eSpark-Consulting-Group/issamsmaali-energymonitor/Design Files/Power_Board-V1.0/Deliverables/Renderings/Power_Board_BOTTON3D.png

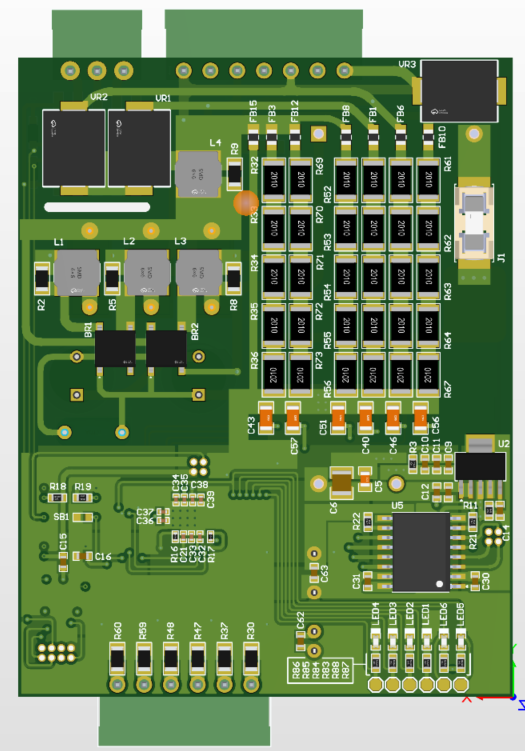
Design Files/Power_Board-V1.0/Deliverables/Renderings/Power_Board_BOTTON3D.png
