eSpark-Consulting-Group/issamsmaali-energymonitor/Design Files/Power_Board-V1.0/Deliverables/BOM/Client-BOM_Power_Board-V1.0.xlsx

# | Item Type | Designator | Description | Footprint | Manufacturer Part Number | Manufacturer | Comment | Quantity | #Column Name Error:' Remarks
1 | Bridge | BR1, BR2 | 30A 950mV@400mA 1A 800V LMBS-1 Bridge Rectifiers ROHS | LMBS-1 | LMB8S-TP | MCC(Micro Commercial Components) | LMB8S-TP | 2
2 | Film Capacitors | C1, C4, C8 | CAP FILM 0.1UF 20% 630VDC RADIAL | B32921C3104M000 | B32921C3104M000 | TDK EPCOS | 0.1uF | 3
3 | Capacitor | C2, C7 | 33uF 420V 1Ω@100kHz 430mA@100kHz ±20% Plugin,D10xL16mm Aluminum Electrolytic Capacitors - Leaded ROHS | 87EC0494 | 87EC0494 | KNSCHA | 33uF | 2
4 | Capacitor | C3 | 10nF -40℃~+100℃ ±5% 1kV Through Hole,P=7.5mm Film Capacitors RoHS | MPBH103J3A0701 | MPBH103J3A0701 | KYET | 10nF | 1
5 | Capacitor | C5 | Multilayer Ceramic Capacitor, 0.1 uF, 50 V, ± 10%, X7R, 0805 [2012 Metric] | Cap-0805 | CL21B104KBCNNNC | Samsung | 0.1uF | 1
6 | Capacitors | C6 | CAP CER 10UF 50V X7R 1210 | Cap-1210 | CC1210KKX7R9BB106 | Yageo | 10uF | 1
7 | Capacitors | C9, C13 | CAP CER 0.1UF 25V X7R 0603 | Cap-0603 | CC0603JRX7R8BB104 | Yageo | 100nF | 2
8 | Capacitor | C10, C11, C12 | CAP CER 4.7UF 16V X5R 0603 | Cap-0603 | CC0603KRX5R7BB475 | Yageo | 4.7uF | 3
9 |  | C14 | CAP CER 10000PF 50V C0G/NP0 0603 | Cap-0603 | GRM1885C1H103JA01D | Murata | 0.01uF | 1
10 | Capacitors | C15, C16, C30, C31 | CAP CER 0.1UF 50V X7R 0603 | Cap-0603 | GCJ188R71H104KA12D | Murata | 0.1uF | 4
11 | Capacitors | C21 | CAP CER 1UF 35V X5R 0402 | Cap-0402 | C1005X5R1V105K050BC | TDK | 1uF | 1
12 | Capacitor | C28, C29 | CAP CER 15PF 50V C0G/NPO 0603 | Cap-0603 | CC0603JRNPO9BN150 | Yageo | 15pF | 2
13 | Capacitor | C32, C34, C36, C38 | CAP CER 0.1UF 25V X5R 0402 | Cap-0402 | CC0402KRX5R8BB104 | Yageo | 100nF | 4
14 |  | C33, C35, C37, C39 | CAP CER 4.7UF 16V X5R 0402 | Cap-0402 | CL05A475MO5NUNC | Samsung | 4.7uF | 4
15 | Capacitors | C40, C43, C46, C51, C56, C57 | CAP CER 0.022UF 500V X7R 1206 | Cap-1206 | CC1206KKX7RBBB223 | Yageo | 22nF | 6
16 | Capacitor | C41, C42, C44, C45, C47, C48, C49, C50, C52, C53, C54, C55 | CAP CER 0.022UF 50V X7R 0603 | Cap-0603 | CC0603KRX7R9BB223 | Yageo | 22nF | 12
17 | Capacitor | C62 | CAP CER 10UF 10V X7R 0603 | Cap-0603 | GRM188Z71A106KA73D | Murata | 10uF | 1
18 | Capacitors | C63 | CAP CER 4.7UF 10V X7R 0603 | Cap-0603 | GRM188Z71A475KE15D | Murata | 4.7uF | 1
19 | Diodes | D1, D2, D3, D4, D5, D6 | DIODE ARR GP 100V 215MA TO-236AB | SOT-23 | BAV99,215 | Nexperia | BAV99,215 | 6
20 | Diode | D9, D10 | DIODE SCHOTTKY 40V 1A SOD123 | SOD-123 | 1N5819HW-7-F | Diodes | 1N5819HW-7-F | 2
21 | Ferrite Beads | FB1, FB2, FB3, FB4, FB5, FB6, FB7, FB8, FB9, FB10, FB11, FB12, FB15 | FERRITE BEAD 1.5 KOHM 0805 1LN | Ind-0805 | BLM21BD152SN1D | Murata | BLM21BD152SN1D | 13
22 | Fuse Holders | J1 | FUSE BLOK CARTRIDGE 125V 10A SMD | 01550900M | 01550900M | Littelfuse | 01550900M | 1
23 | Terminal Blocks | J2 | TERM BLOCK HDR 7POS 3.50MM | 691322110007 | 691322110007 | Wurth Elektronik | 691322110007 | 1
24 | Terminal Blocks | J3 | TERM BLOCK HDR 6POS 3.50MM | 691322110006 | 691322110006 | Wurth Elektronik | 691322110006 | 1
25 | Terminal Blocks | J4 | TERM BLOCK HDR 3POS 3.50MM | 691322110003 | 691322110003 | Wurth Elektronik | 691322110003 | 1
26 | Headers | J7, J8 | Socket Strip, Cuttable, Double Row, 0.050"x0.050" Pitch | SFMC-102-X1-XX-D - 570 |  | SAMTEC | SFMC-102-X1-XX-D | 2
27 | Header | J9 | Socket Strip, Cuttable, Double Row, 0.050"x0.050" Pitch | SFMC-104-X1-XX-D - 570 |  | SAMTEC | SFMC-104-X1-XX-D | 1
28 | Signal Relays | K1 | RELAY TELECOM DPDT 500MA 5V | TQ2SA-L2-5V-Z | TQ2SA-L2-5V-Z | Panasonic | TQ2SA-L2-5V-Z | 1
29 | Inductor | L1, L2, L3, L4 | 420mA 470uH Magnetic Shielded Inductor ±20% 500mA 1.8Ω SMD,6x6mm Fixed Inductors ROHS | XRNR6045-470uH/M | XRNR6045-470uH/M | XR | 470uH | 4
30 | LED | LED1, LED2, LED3, LED4, LED5, LED6 | Emerald 0603 Light Emitting Diodes (LED) ROHS | LED-0603 | NCD0603G2 | Foshan NationStar Optoelectronics | Emerald | 6
31 | MOSFETs | Q1, Q2 | MOSFET BVDSS: 8V~24V SOT23 T&R 3 | SOT-23 | DMG3420UQ-7 | Diodes | DMG3420UQ-7 | 2
32 | Resistor | R1, R4, R7 | 3W 1Ω SMD ±50ppm/℃ Current Sense Resistor ±1% 2512 Chip Resistor - Surface Mount RoHS | RES-2512 | HoLRT2512-3W-1R-1 | Milliohm | 1R | 3
33 | Resistors | R2, R5, R8, R9 | RES 10K OHM 1% 1/2W 1206 | Res-1206 | AC1206FR-7W10KL | Yageo | 10K | 4
34 | Resistor | R3 | RES 0 OHM JUMPER 1/10W 0603 | Res-0603 | RC0603JR-070RL | Yageo | 0R | 1
35 | Resistor | R11 | RES 0 OHM JUMPER 1/10W 0603 | Res-0603 | RC0603JR-070RL | Yageo | DNP | 1
36 | Resistors | R12, R15, R77, R79 | RES 0 OHM JUMPER 1/16W 0402 | Res-0402 | RC0402FR-070RL | Yageo | 0R | 4
37 | Resistors | R13, R14 | RES 0 OHM JUMPER 1/16W 0402 | Res-0402 | RC0402FR-070RL | Yageo | DNP | 2
38 | Resistor | R16 | RES 10K OHM 1% 1/16W 0402 | Res-0402 | RC0402FR-0710KL | Yageo | 10K | 1
39 | Resistor | R17 | RES 10K OHM 1% 1/16W 0402 | Res-0402 | RC0402FR-0710KL | Yageo | DNP | 1
40 | Resistor | R18, R19, R21, R22 | RES SMD 4.7K OHM 1% 1/10W 0603 | Res-0603 | RC0603FR-074K7L | Yageo | 4.7K | 4
41 | Resistor | R20, R89 | RES 1K OHM 1% 1/16W 0402 | Res-0402 | RC0402FR-071KL | Yageo | 1K | 2
42 | Resistor | R23, R24, R25, R26, R32, R33, R34, R35, R40, R41, R42, R43, R52, R53, R54, R55, R61, R62, R63, R64, R69, R70, R71, R72 | 0.75W Thick Film Resistors 200V ±100ppm/℃ ±5% 200kΩ 2010 Chip Resistor - Surface Mount ROHS | RES-2010 | FRC2010J204 TS | FOJAN | 200K | 24
43 | Resistor | R27, R36, R46, R56, R67, R73 | 1W 1kΩ 300V ±100ppm/℃ Thick Film Resistor ±5% 2010 Chip Resistor - Surface Mount RoHS | RES-2010 | HP101WJ0102T4E | UNI-ROYAL | 1K | 6
44 | Resistor | R28, R38, R44, R49, R57, R65 | RES SMD 0R, 1%, 0.1W, 0603 | Res-0603 | RC0603FR-070RL | Yageo | 0R | 6
45 | Resistor | R29, R39, R45, R50, R58, R66 | RES SMD 1K OHM 1% 1/10W 0603 | Res-0603 | RC0603FR-071KL | Yageo | 1K | 6
46 | Resistor | R30, R37, R47, R48, R59, R60 | RES 5.1 OHM 5% 1/4W 1206 | Res-1206 | RC1206JR-075R1L | Yageo | 5.1R | 6
47 | Resistor | R83, R84, R85, R86, R87, R88 | RES SMD 680 OHM 1% 1/10W 0603 | Res-0603 | RC0603FR-07680RL | Yageo | 680R | 6
48 | Resistor | R90, R91 | RES 100K OHM 1% 1/16W 0402 | Res-0402 | RC0402FR-07100KL | Yageo | 100K | 2
49 | Voltage Regulators - Switching | U1 | AC/DC CONVERTER 5V 5W | RAC05-05SK/480 | RAC05-05SK/480 | Recom Power | RAC05-05SK/480 | 1
50 | IC | U2 | IC REG LINEAR 3.3V 1A SOT223-6 | SOT-223-6_ | TPS79633DCQR | Texas Instruments | TPS79633DCQR | 1
51 | IC | U3 | IC AFE 7 CHAN 40LFCSP-WQ | 40-LFCSP-WQ (6x6) | ADE9000ACPZ | Analog Devices | ADE9000ACPZ | 1
52 | IC | U4, U5 | DGTL ISO 5000VRMS 4CH GP 16SOIC | SOIC-16-300mil | ISO7741DWR | Texas Instruments | ISO7741DWR | 2
53 | Module | U6 | SIP-4 Isolated Power Modules ROHS | B0503S-2WR3 | B0503S-2WR3 | YLPTEC | B0503S-2WR3 | 1
54 | Varistor | VR1, VR2, VR3 | 710V 350V 275V Through Hole,P=10mm Varistors ROHS | 4032 | 20D431K | SURGING | 20D431K | 3
55 | Crystal | X1 | 24.576MHz Surface Mount Crystal 12pF ±10ppm ±20ppm SMD3225-4P Crystals ROHS | SMD3225-4P | X322524576MOB4SI | YXC | 24.576MHz | 1
