eSpark-Consulting-Group/issamsmaali-energymonitor/Design Files/Power_Board-V1.0/Deliverables/Supporting Files/Power_Board-V1.0.step

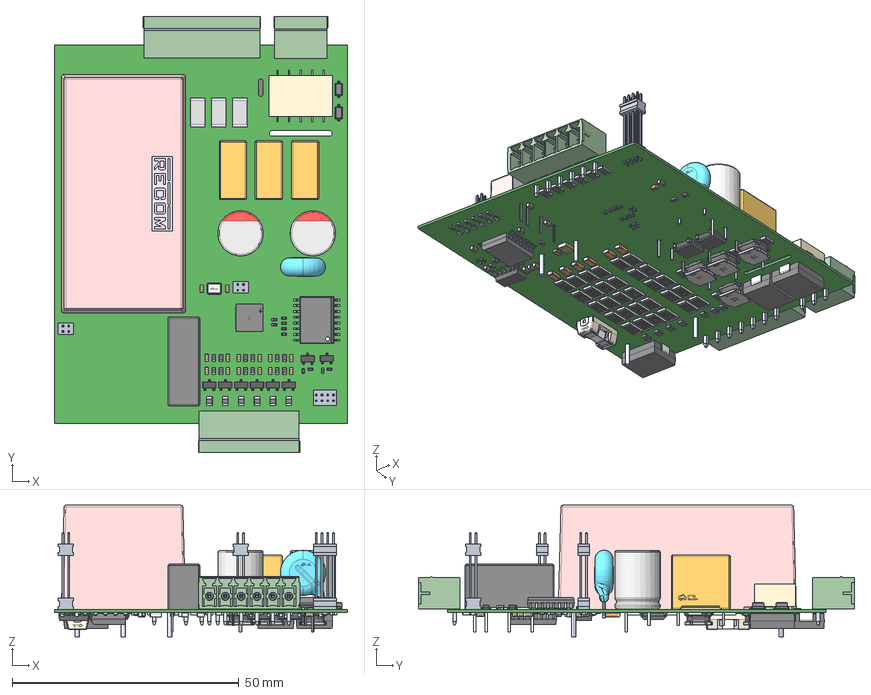
[picture p6: CAD file, 2026-02-13]
Design Files/Power_Board-V1.0/Deliverables/Supporting Files/Power_Board-V1.0.step
64.6 x 96.2 x 29.0 mm
_FW-04-01-G-D-570-100_bottom_body
_FW-04-01-G-D-570-100_pins1
_FW-04-01-G-D-570-065_pins2
_FW-04-01-G-D-570-100_top_body
_FW-02-01-G-D-570-100_bottom_body x 2
_FW-02-01-G-D-570-100_pins1 x 2
_FW-02-01-G-D-570-065_pins2 x 2
_FW-02-01-G-D-570-100_top_body x 2
User Library-CR3216-1206 x 10
User Library-R_2010 x 30
User Library-RESC1608X05N x 24
User Library-User Library-Siward_SX3225
ISO1050DWR x 2
User Library-SOT-223-6
RAC05-05SK_480
User Library-RES_1005-0402 x 12
CircuitWorks-RESISTOR 2512 x 3
CircuitWorks-SOT-23 x 8
User Library-LED SMD0603 x 6
RELAY-SMD_TQ2SA-3V~RELAY-SMD_TQ2SA-3V~12Oy
6913221100xx_PIN x 16
1N5819HW-7-F--3DModel-STEP-56544 x 2
User Library-CAPC1608X09 x 26
User Library-1206 SMD Capacitor x 6
User Library-Capacitor 0402 x 9
User Library-CAPC3225X10
User Library-0805 SMD Capacitor
