eSpark-Consulting-Group/issamsmaali-energymonitor/(list of files, cad)

Other CAD files:
docs/Client-Files/P24- board1.DWG
docs/Client-Files/25_0510000_bl(Alternate).dxf
Design Files/Power_Board-V1.0/Deliverables/Supporting Files/Power_Board-V1.0.DWG
Design Files/Power_Board-V1.0/Deliverables/Supporting Files/Power_Board-V1.0.DXF
