eSpark-Consulting-Group/issamsmaali-energymonitor/Design Files/Power_Board-V1.0/Power_Board-V1.0.pdf

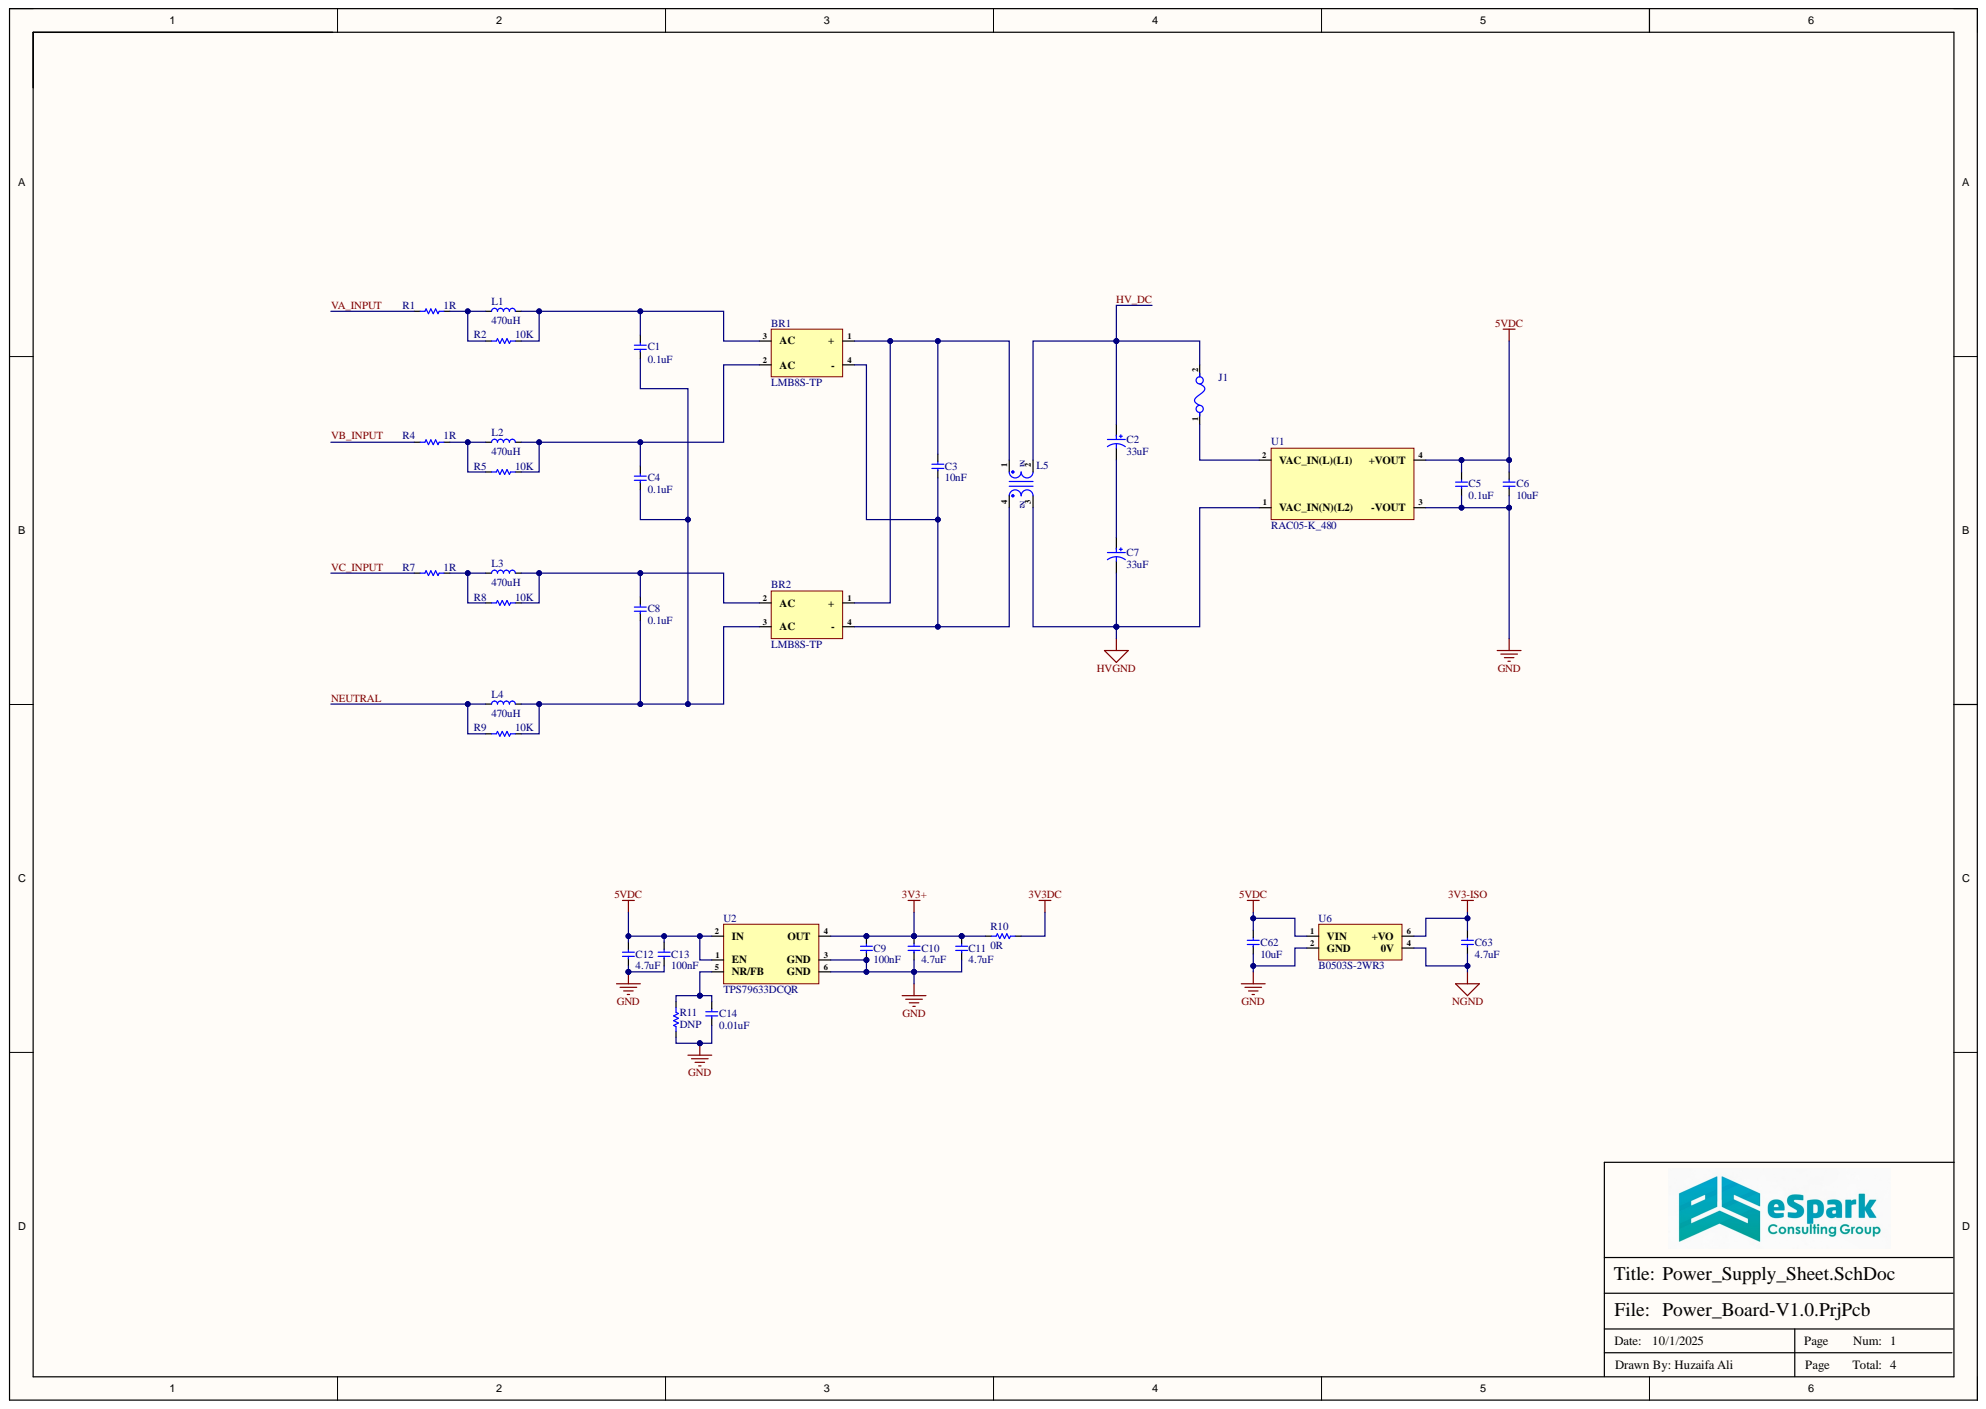
[picture p7: page 1]

Date: 10/1/2025 | Page Num: 1

Drawn By: Huzaifa Ali | Page Total: 4

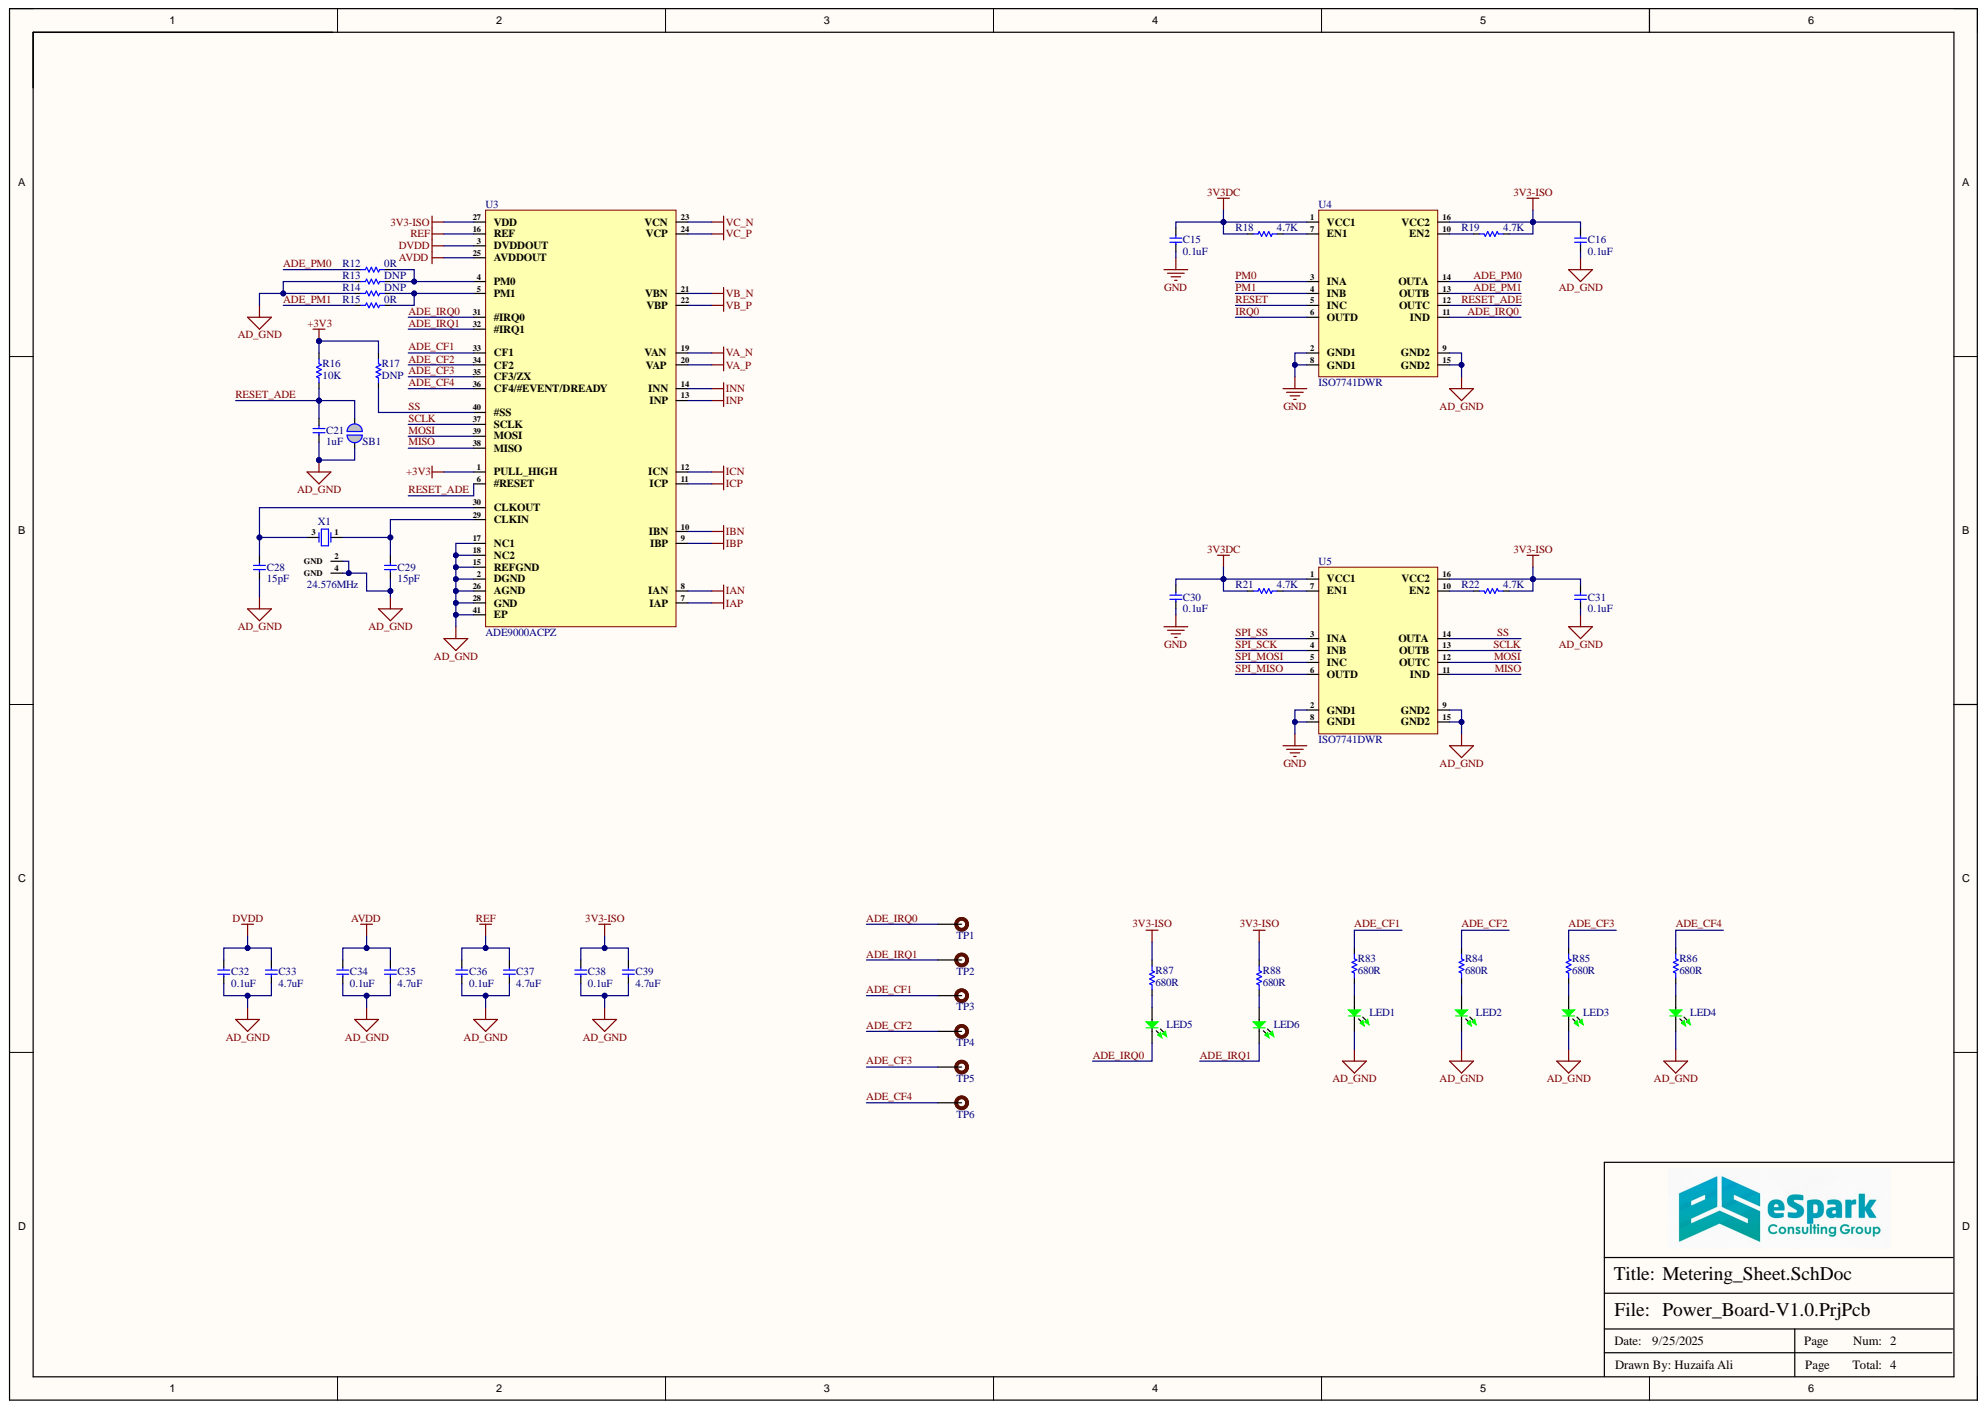
[picture p8: page 2]

Date : 9/2 5/2 0 2 5 | P a g e Nu m : 24

Drawn By: Hu z aifa Ali | P a g e T ota l :

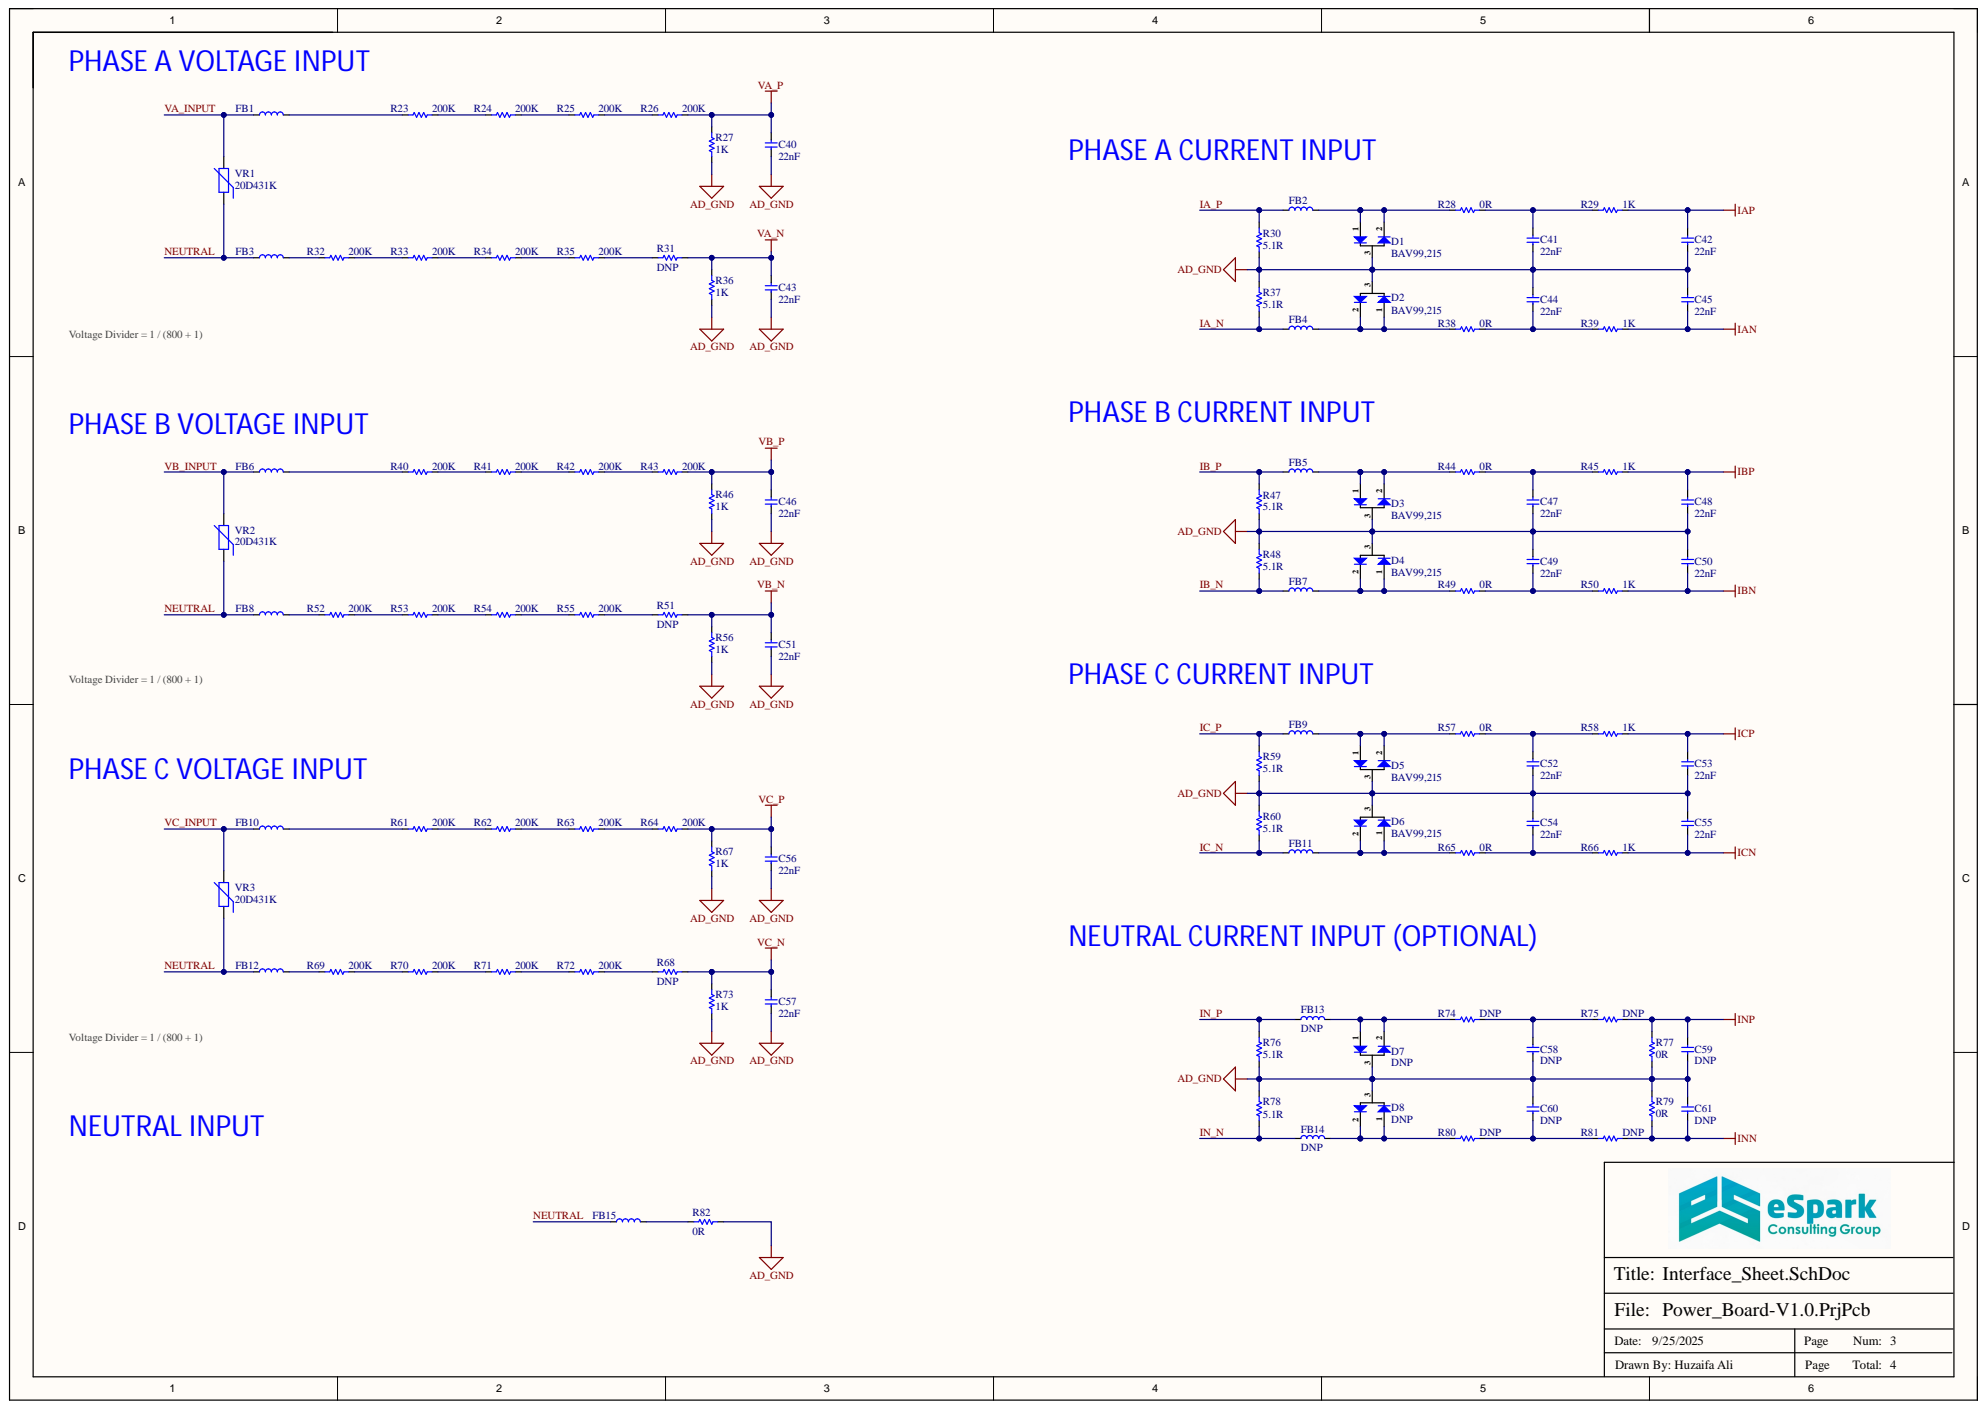
[picture p9: page 3]

Voltage Divider = 1 / (800 + 1) Voltage Divider = 1 / (800 + 1) Voltage Divider = 1 / (800 + 1)

NEUTRAL CURRENT INPUT (OPTIONAL)

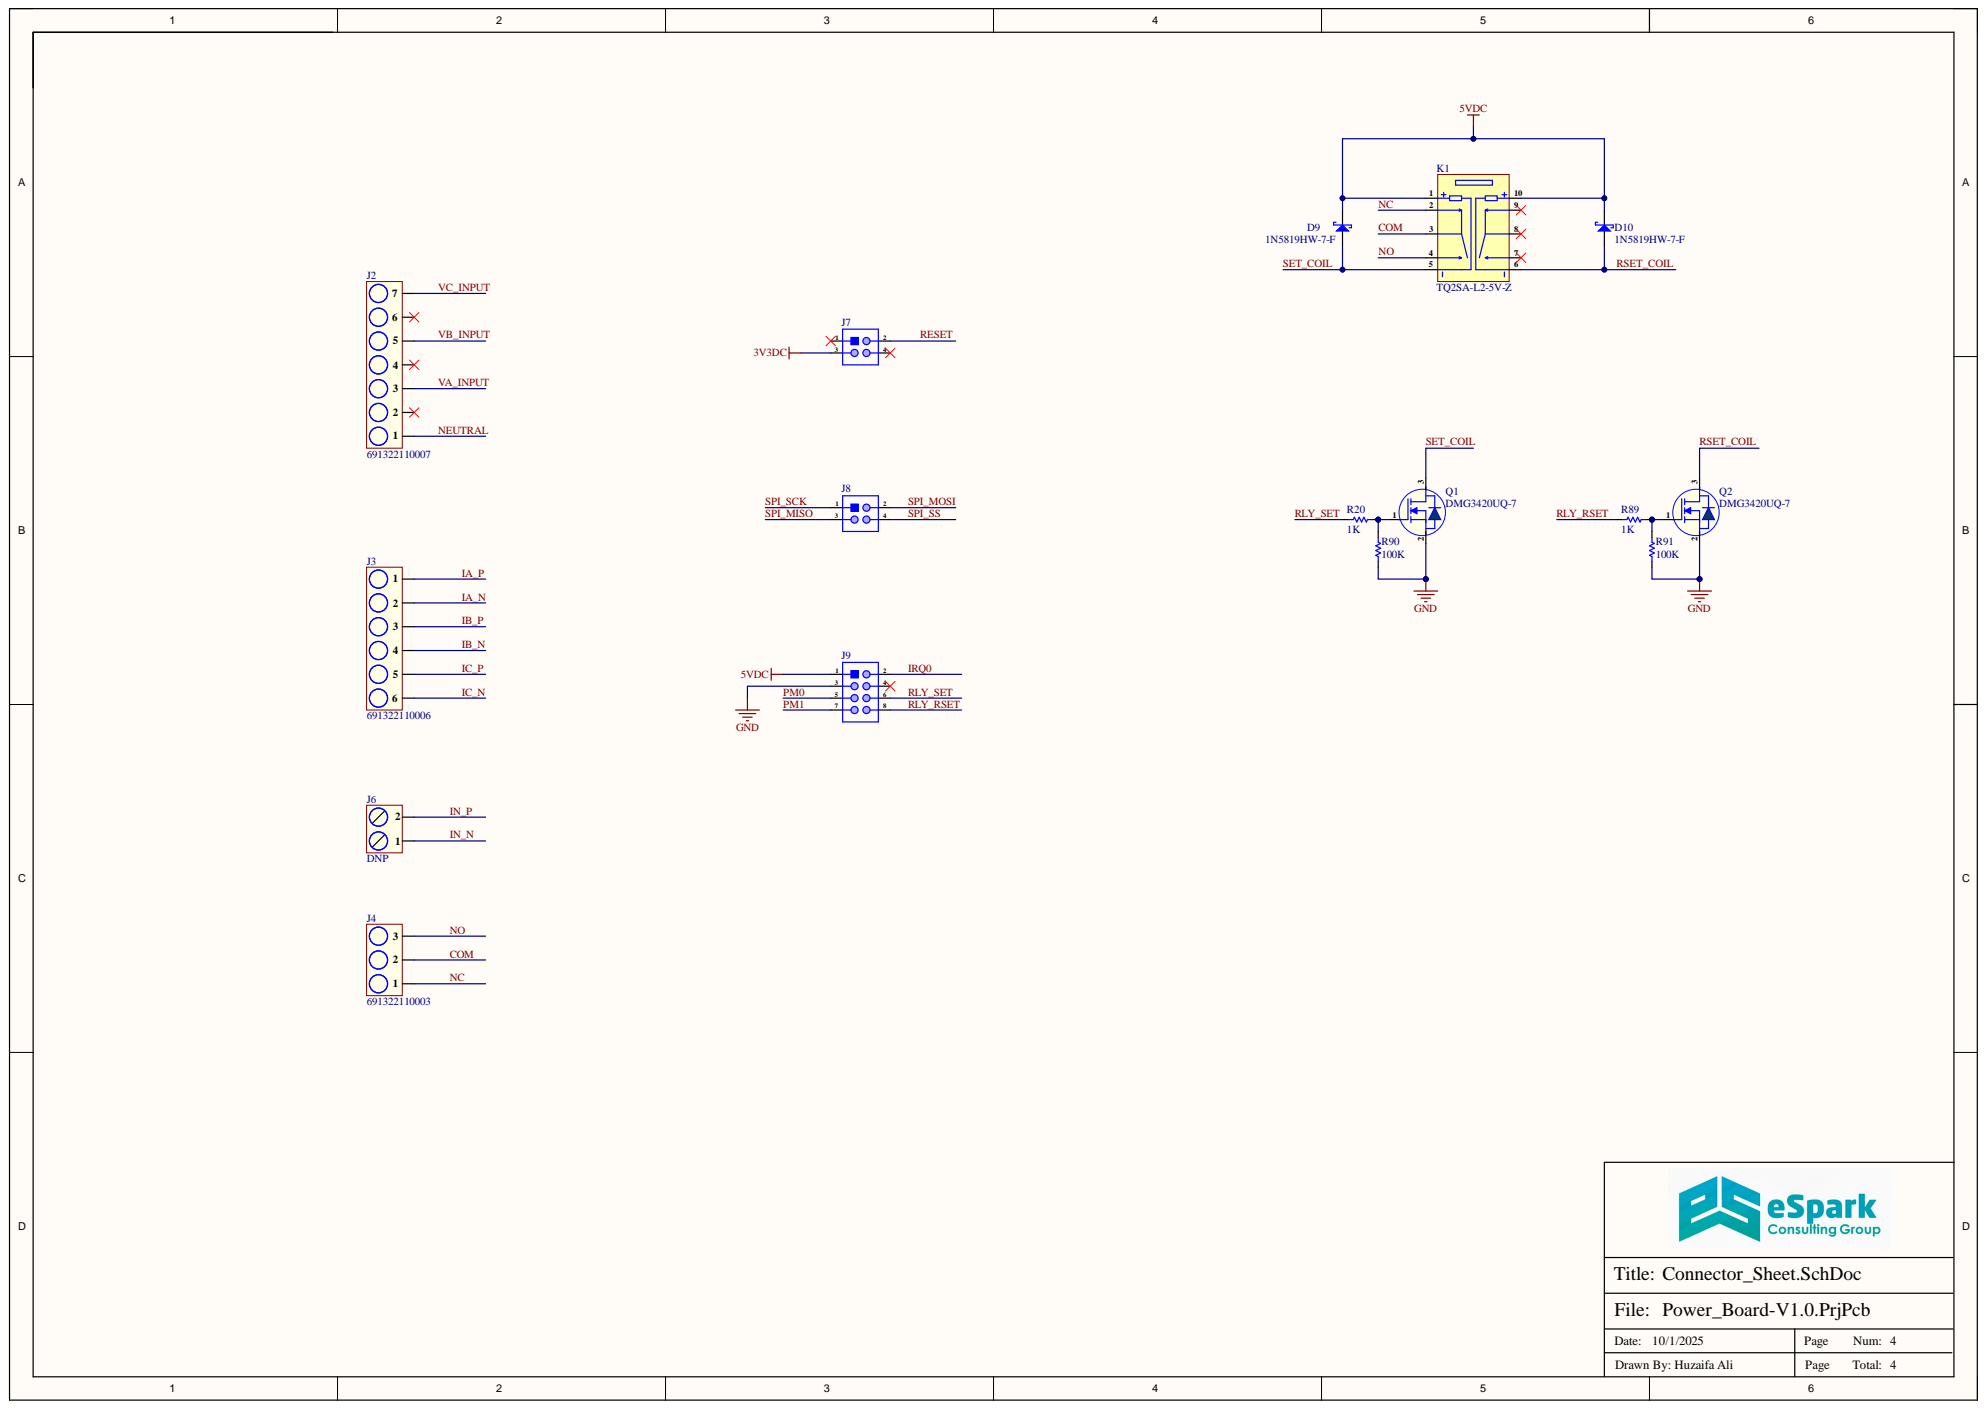
[picture p10: page 4]
