eSpark-Consulting-Group/issamsmaali-energymonitor/Design Files/Power_Board-V1.0/Deliverables/Schematic/Power_Board-V1.0.pdf

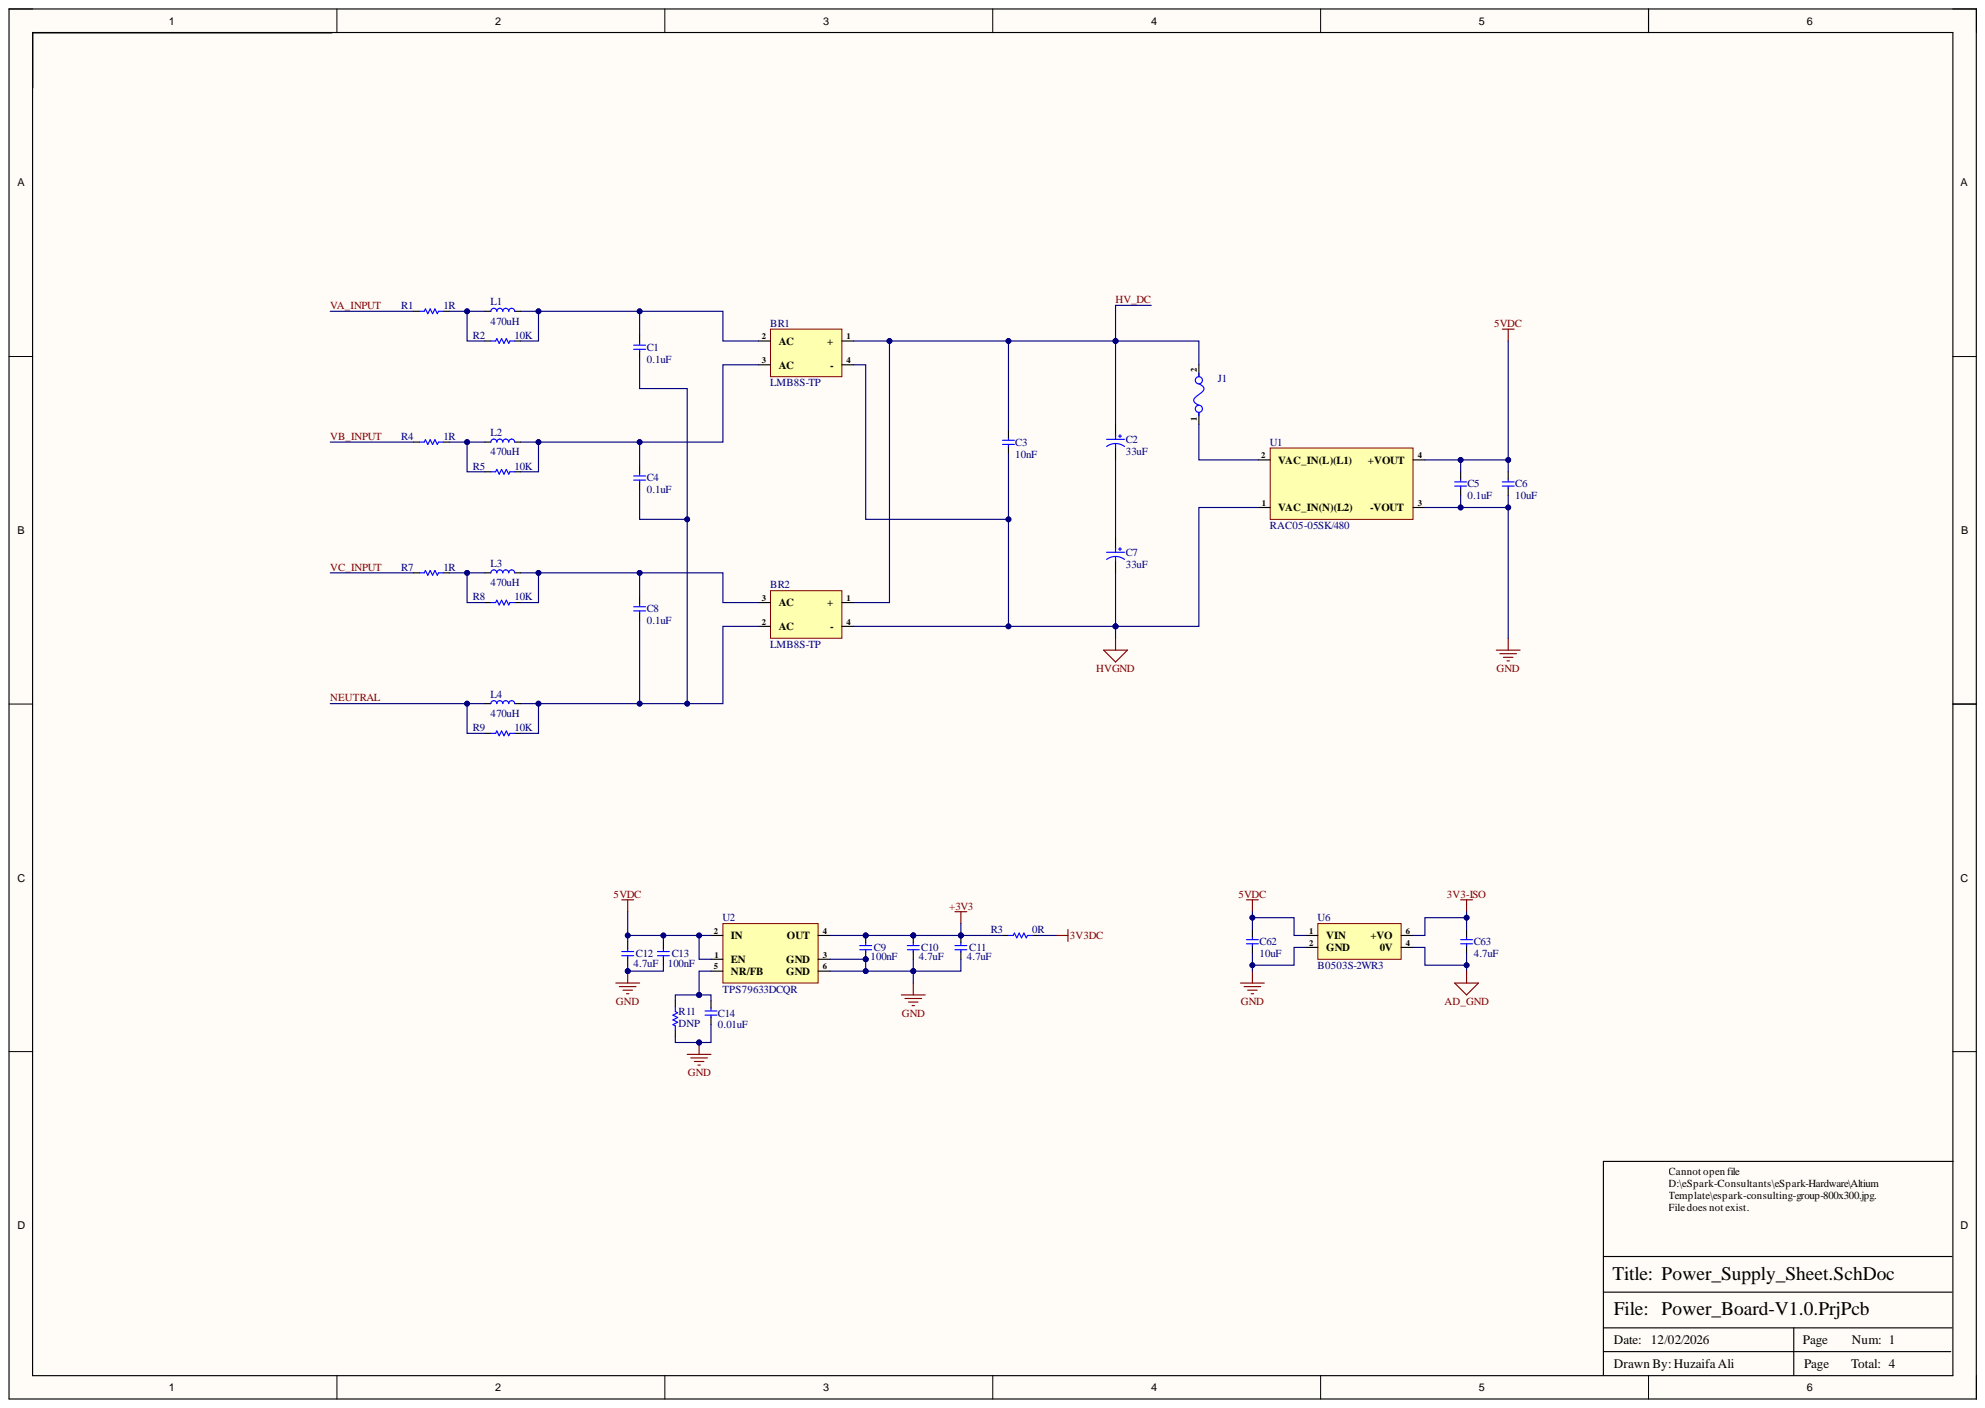
[picture p11: page 1]

Date: | Pag e N u m :

D raw n B y H uzai fa A l i | To tal

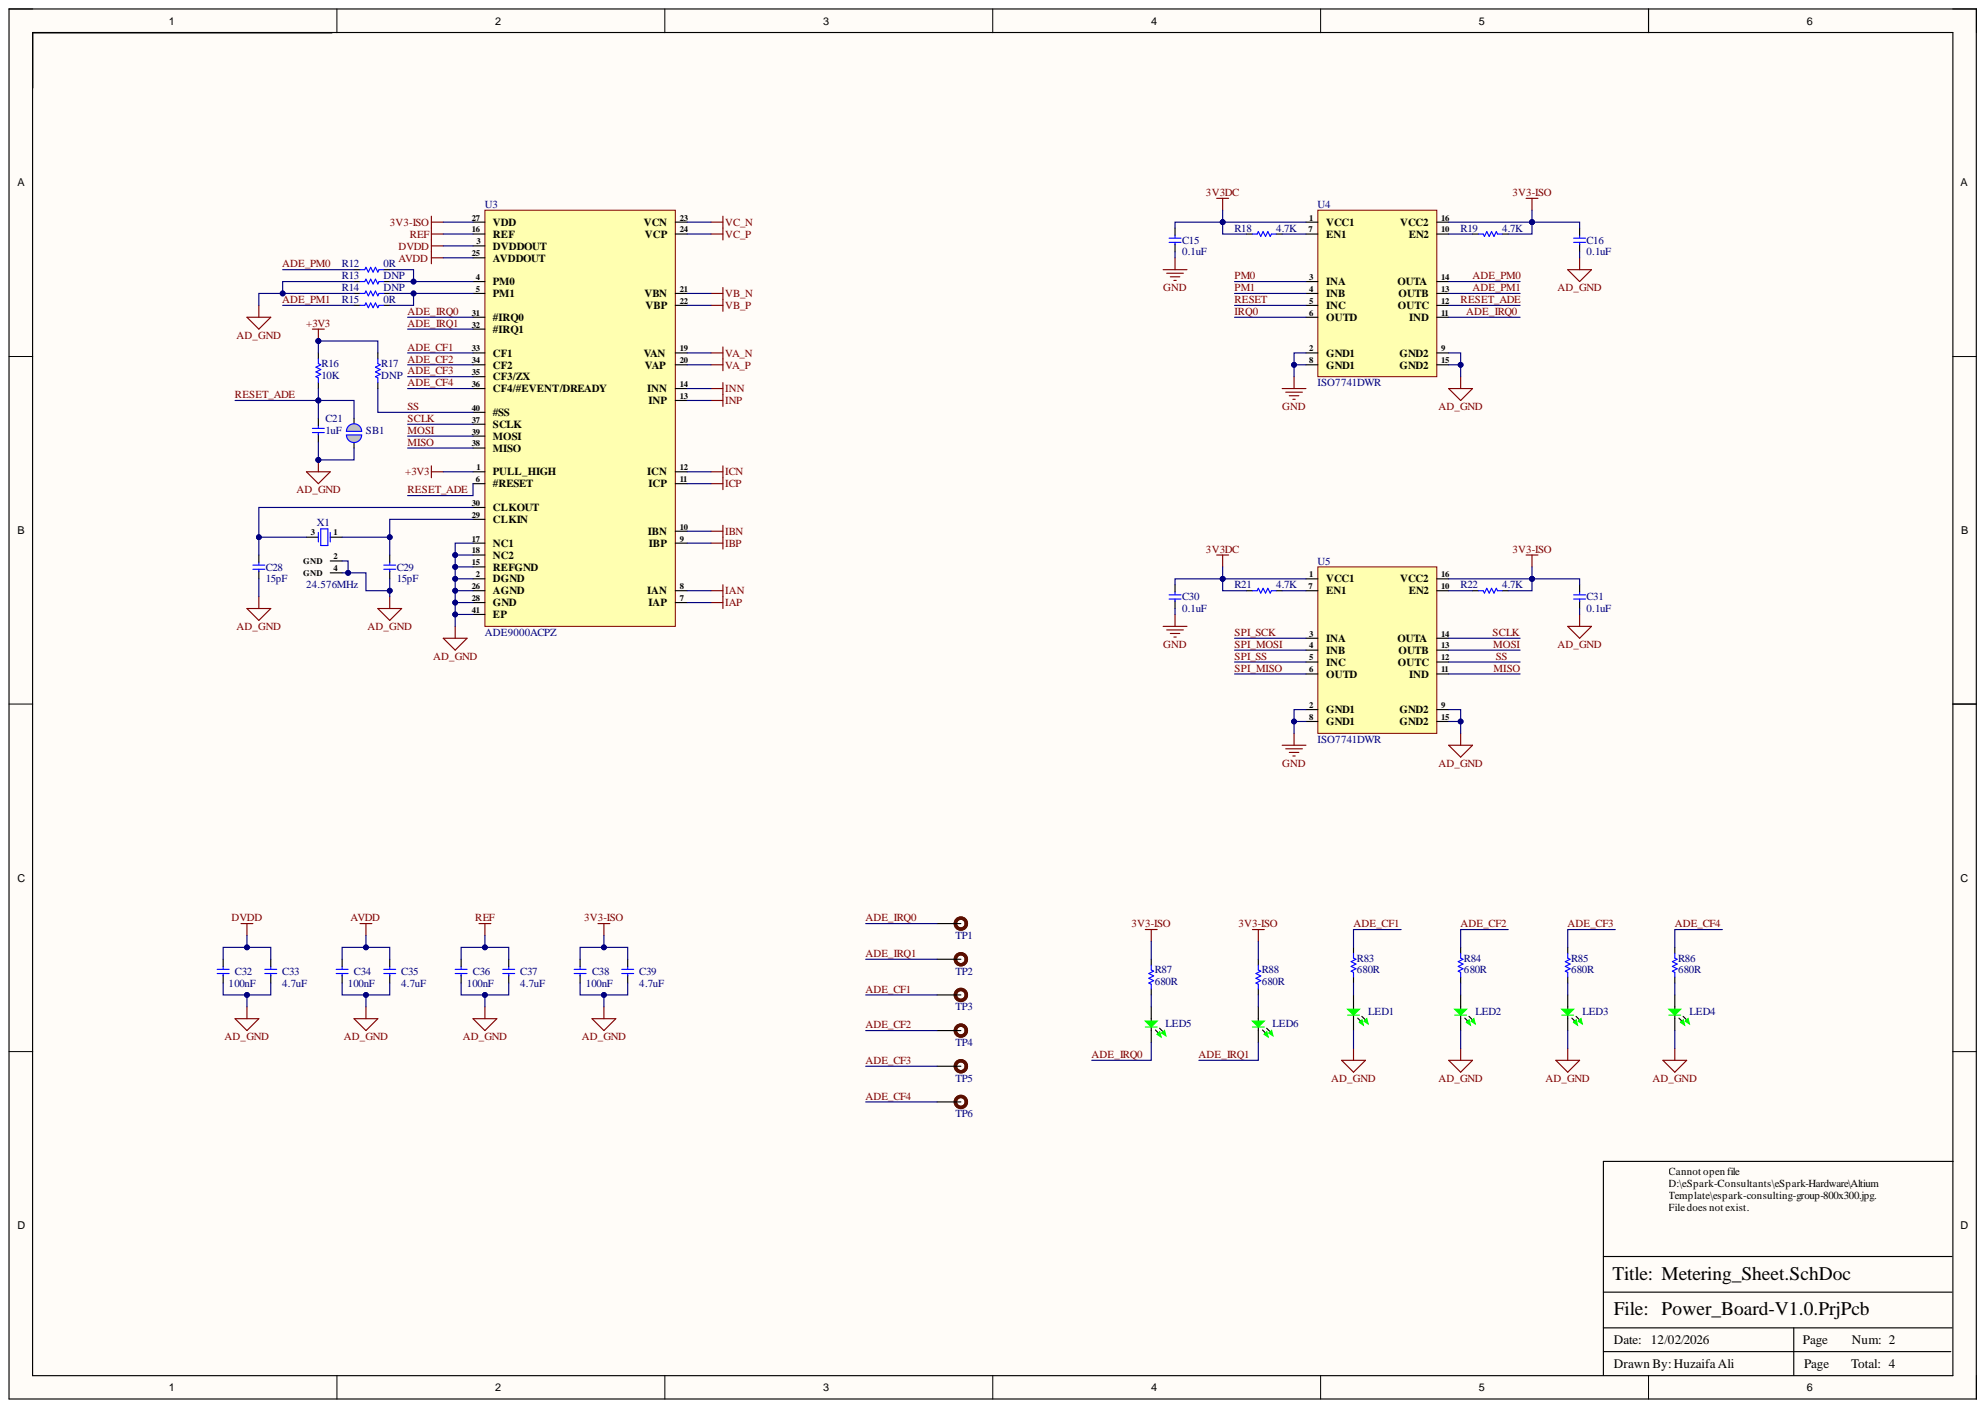
[picture p12: page 2]

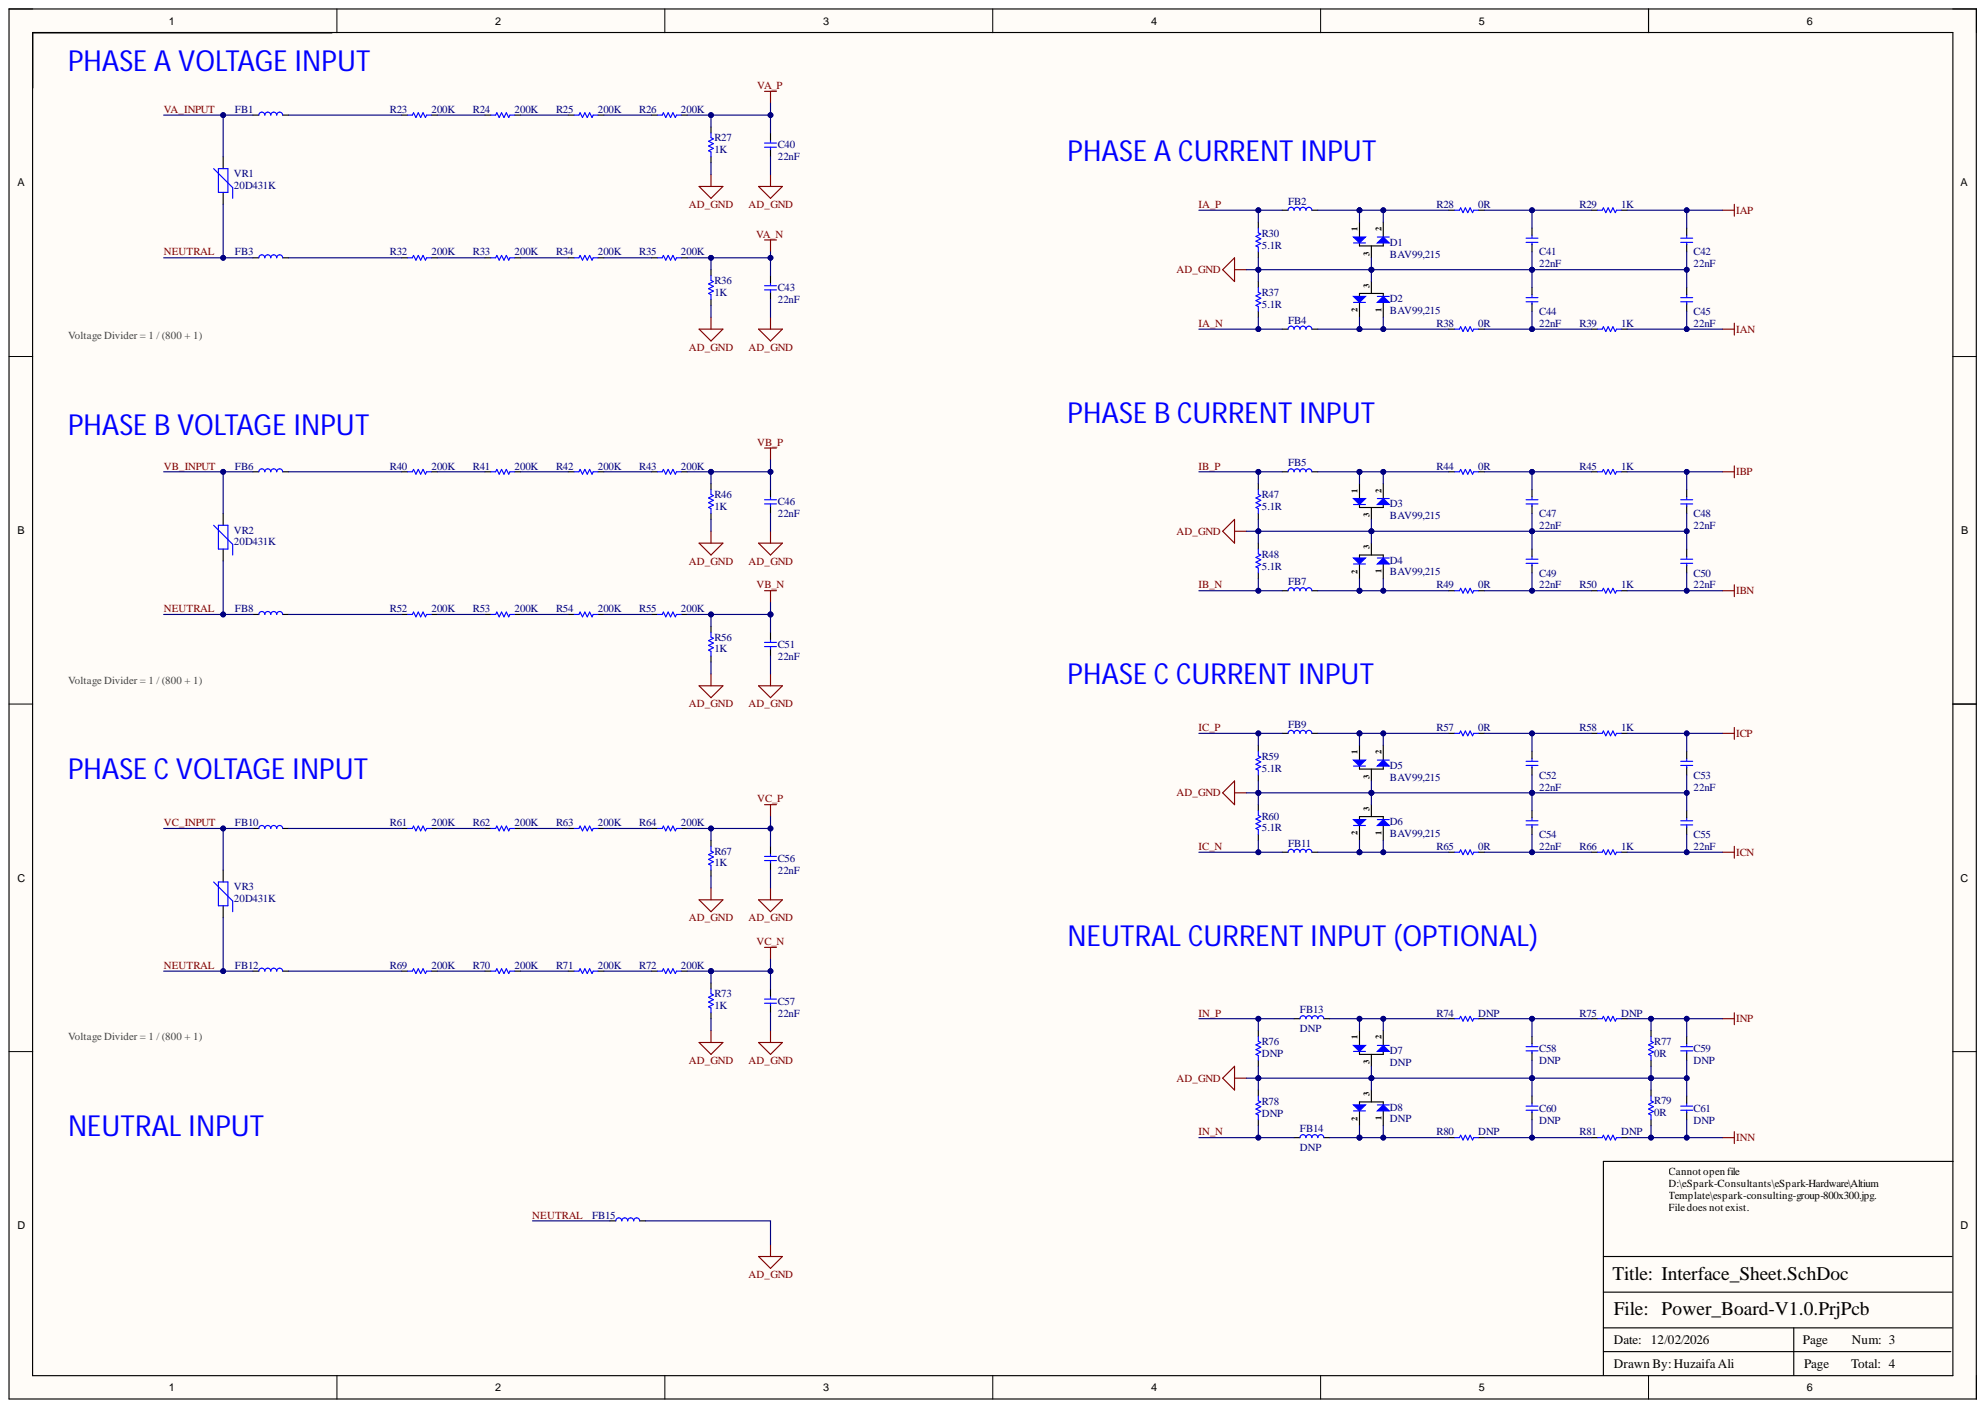
[picture p13: page 3]

NEUTRAL CURRENT INPUT (OPTIONAL)

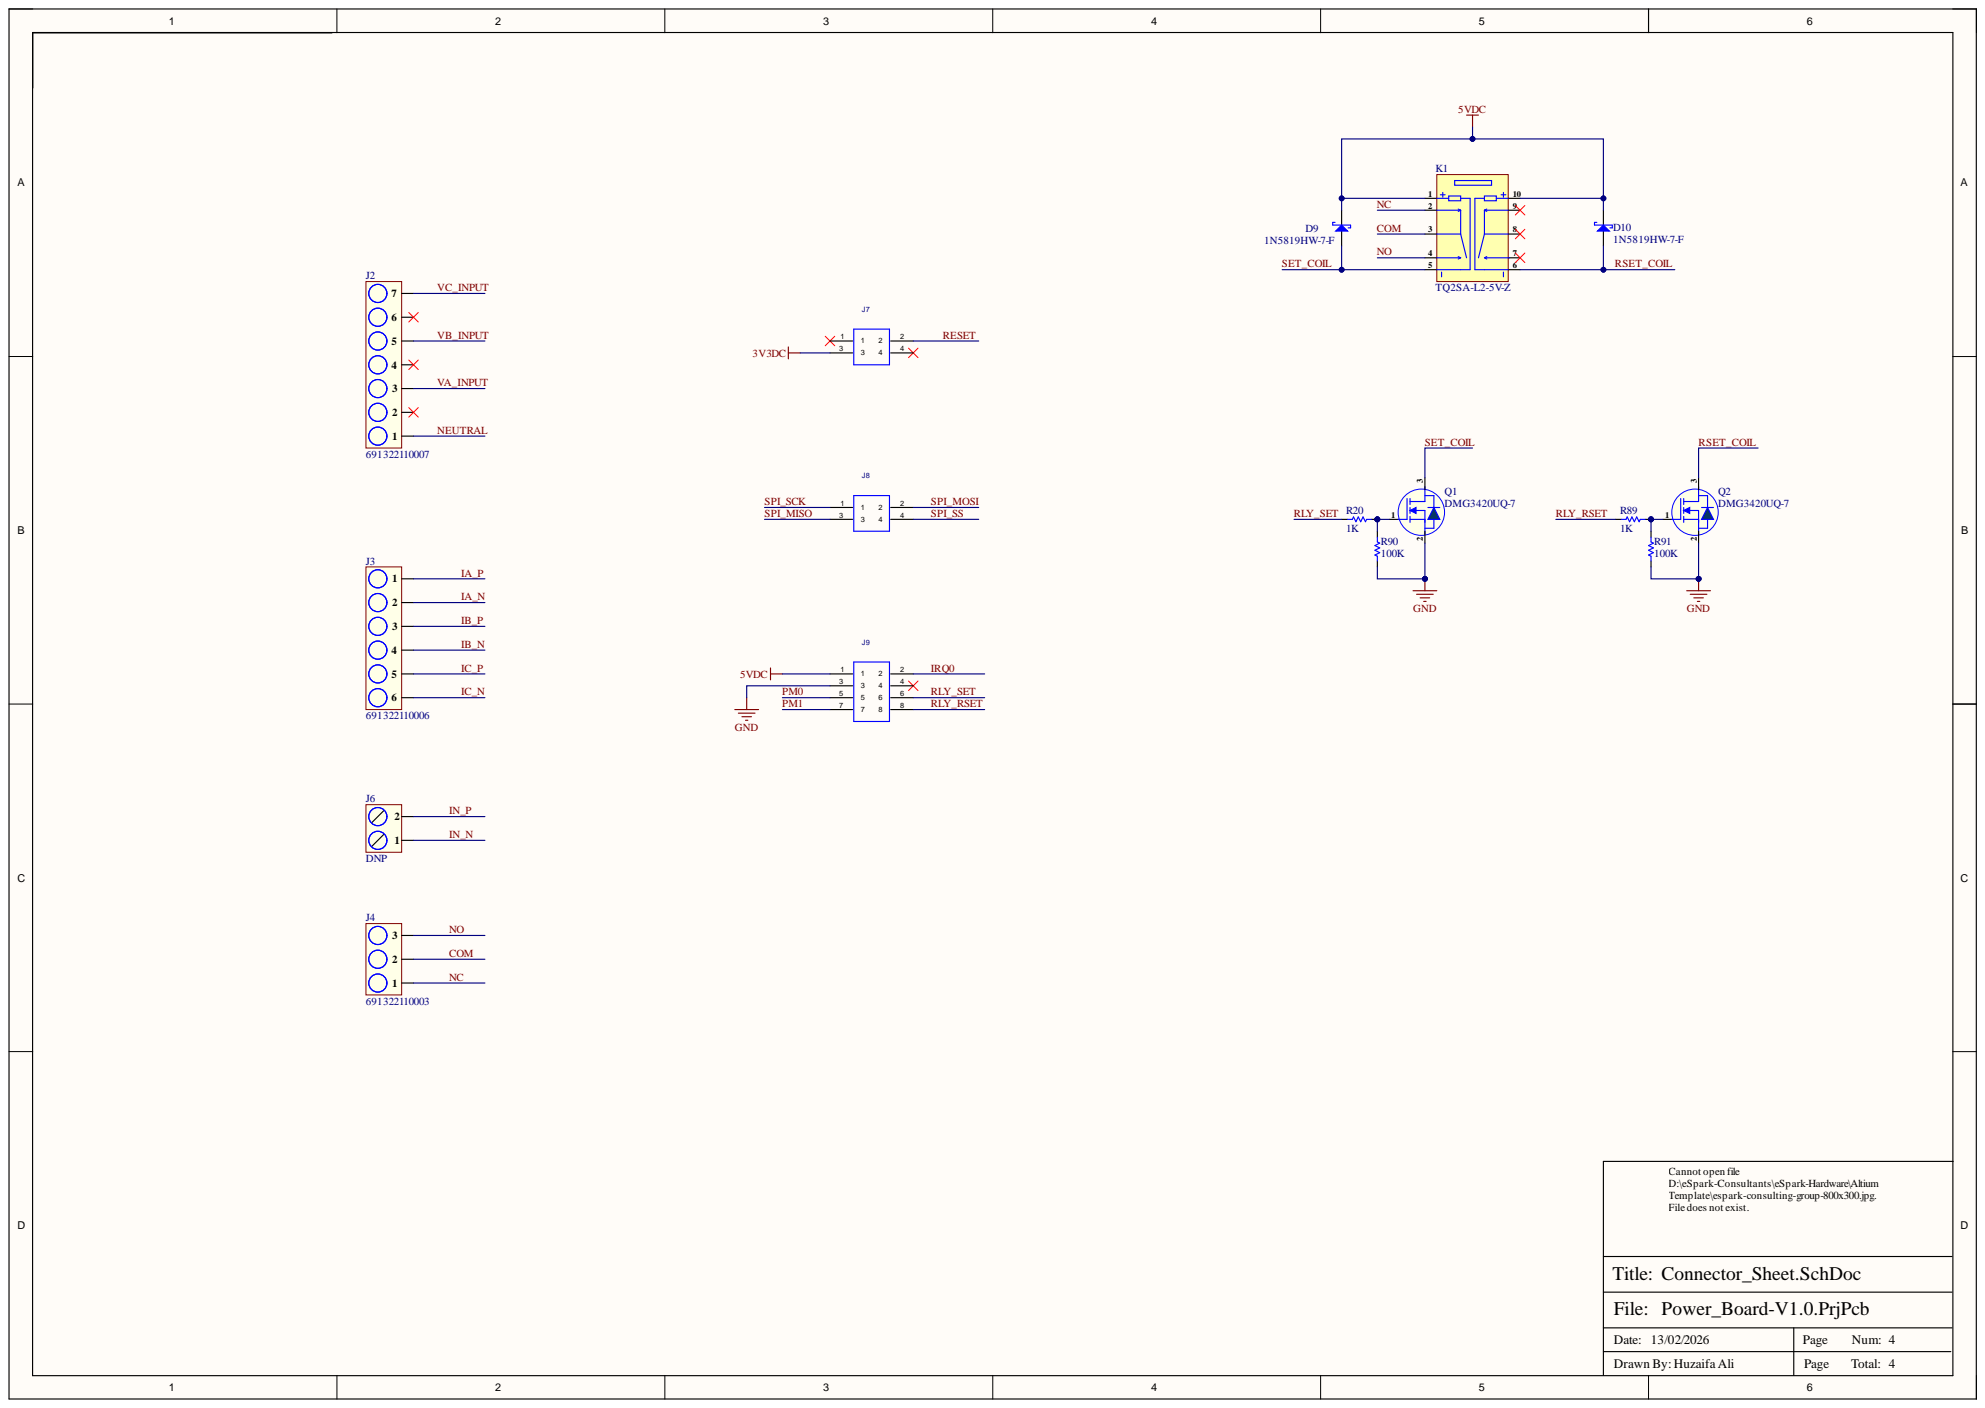
[picture p14: page 4]
