eSpark-Consulting-Group/issamsmaali-energymonitor/docs/Client-Files/ProcessingGSM-Y79.pdf

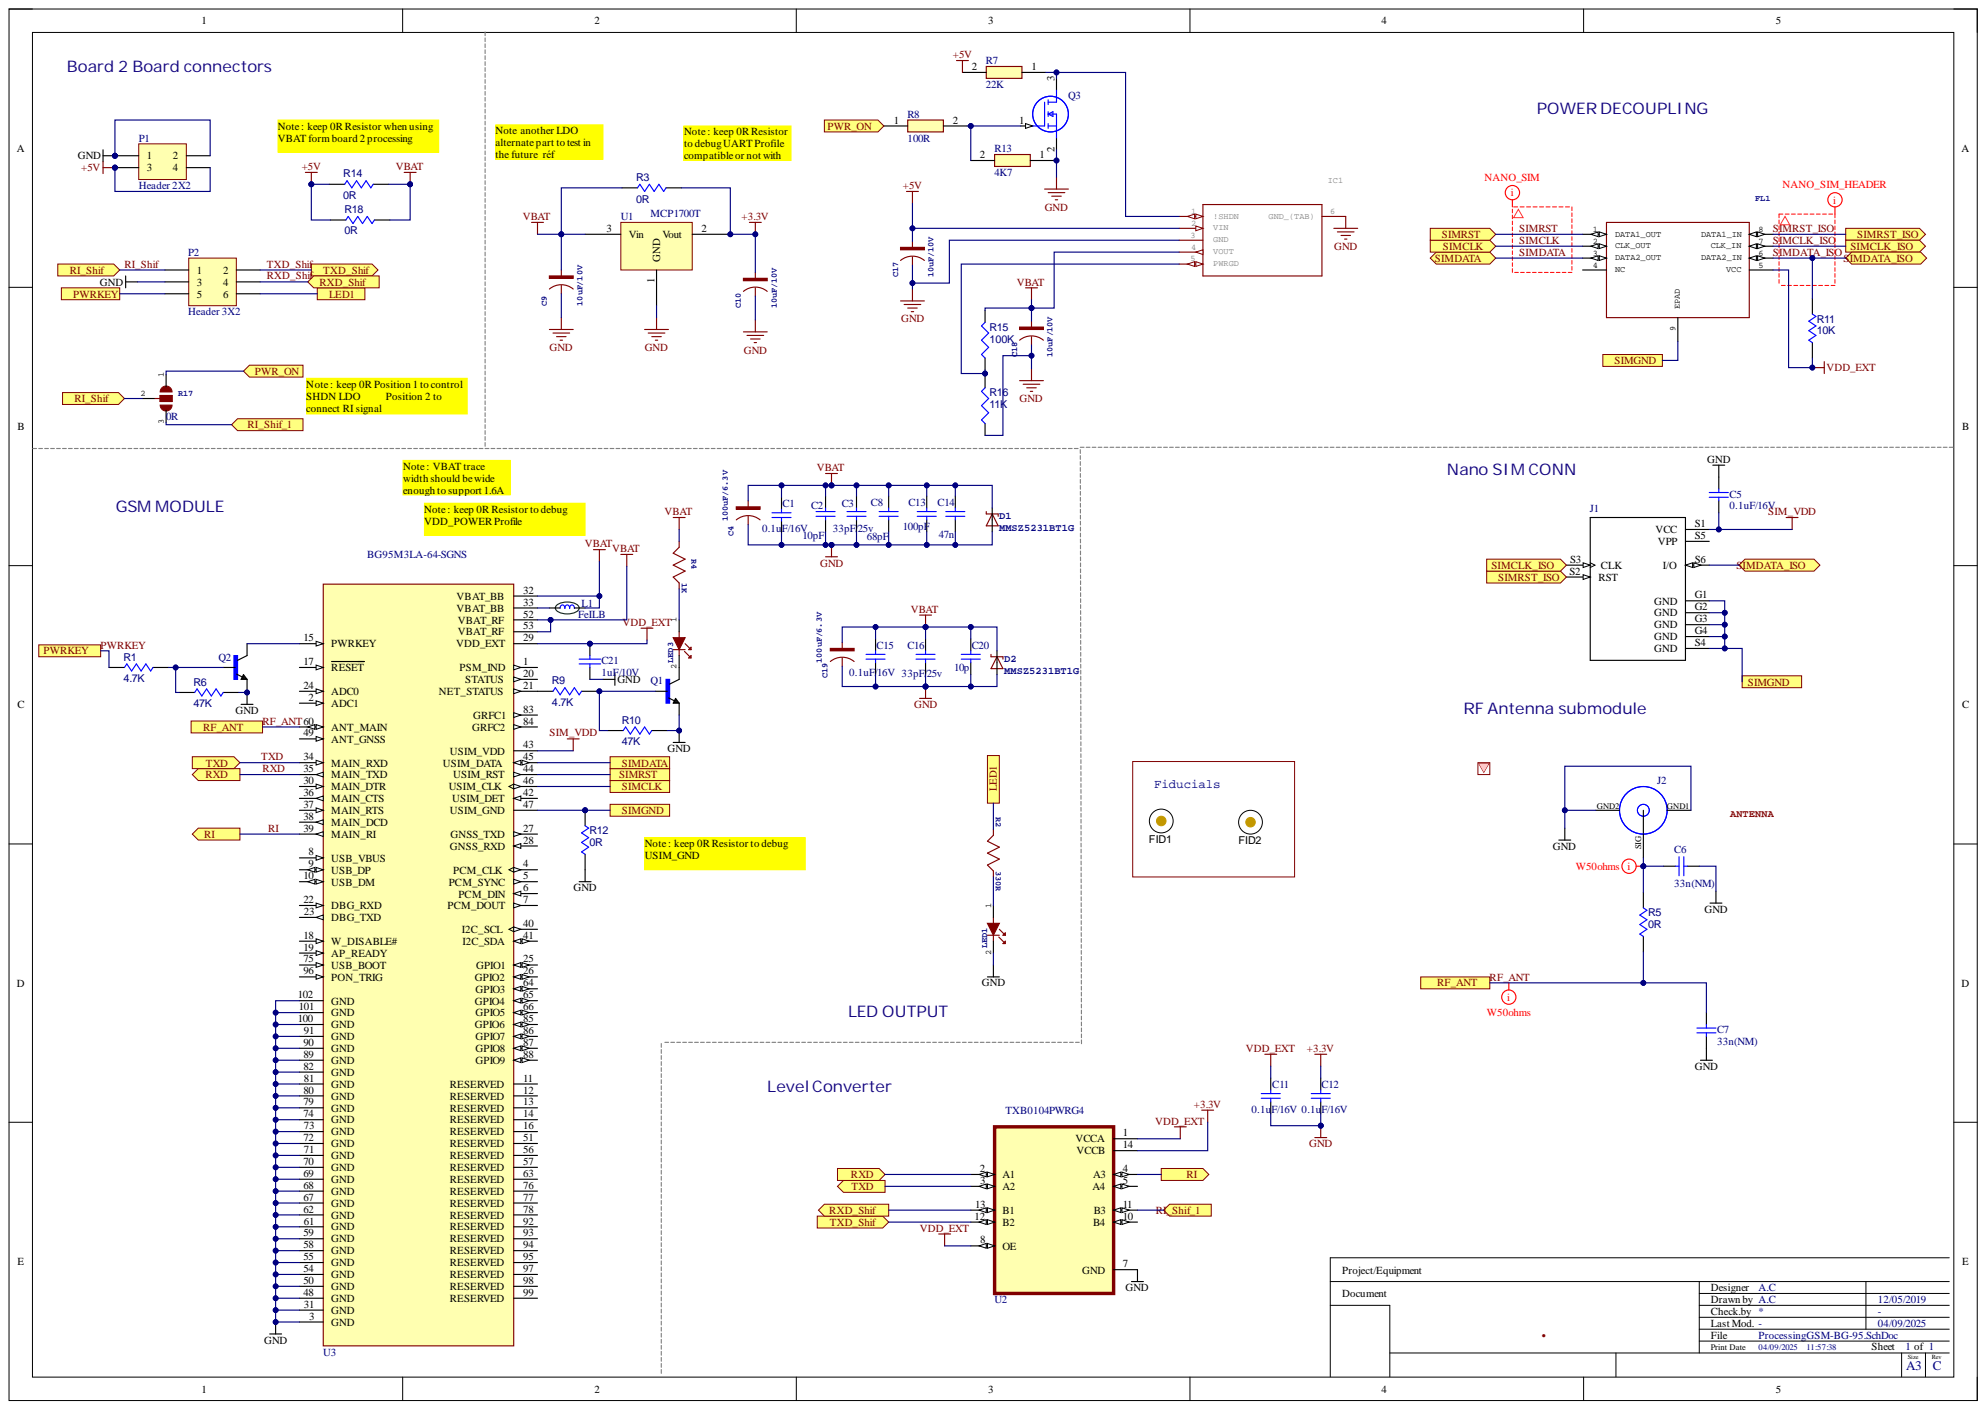
[picture p15: page 1]

Note : keep 0R Resistor when using
VBAT form board 2 processing

Note another LDO
alternate part to test in
the future réf

Note : keep 0R Resistor
to debug UART Profile
compatible or not with

1 2
3 4

Note : keep 0R Position 1 to control
connect RI signal

GND Note : VBAT trace

width should be wide
enough to support 1.6A

Note : keep 0R Resistor to debug
VDD_POWER Profile

USIM_GND
