eSpark-Consulting-Group/issamsmaali-energymonitor/docs/Client-Files/Schematic_P25 (1).PDF

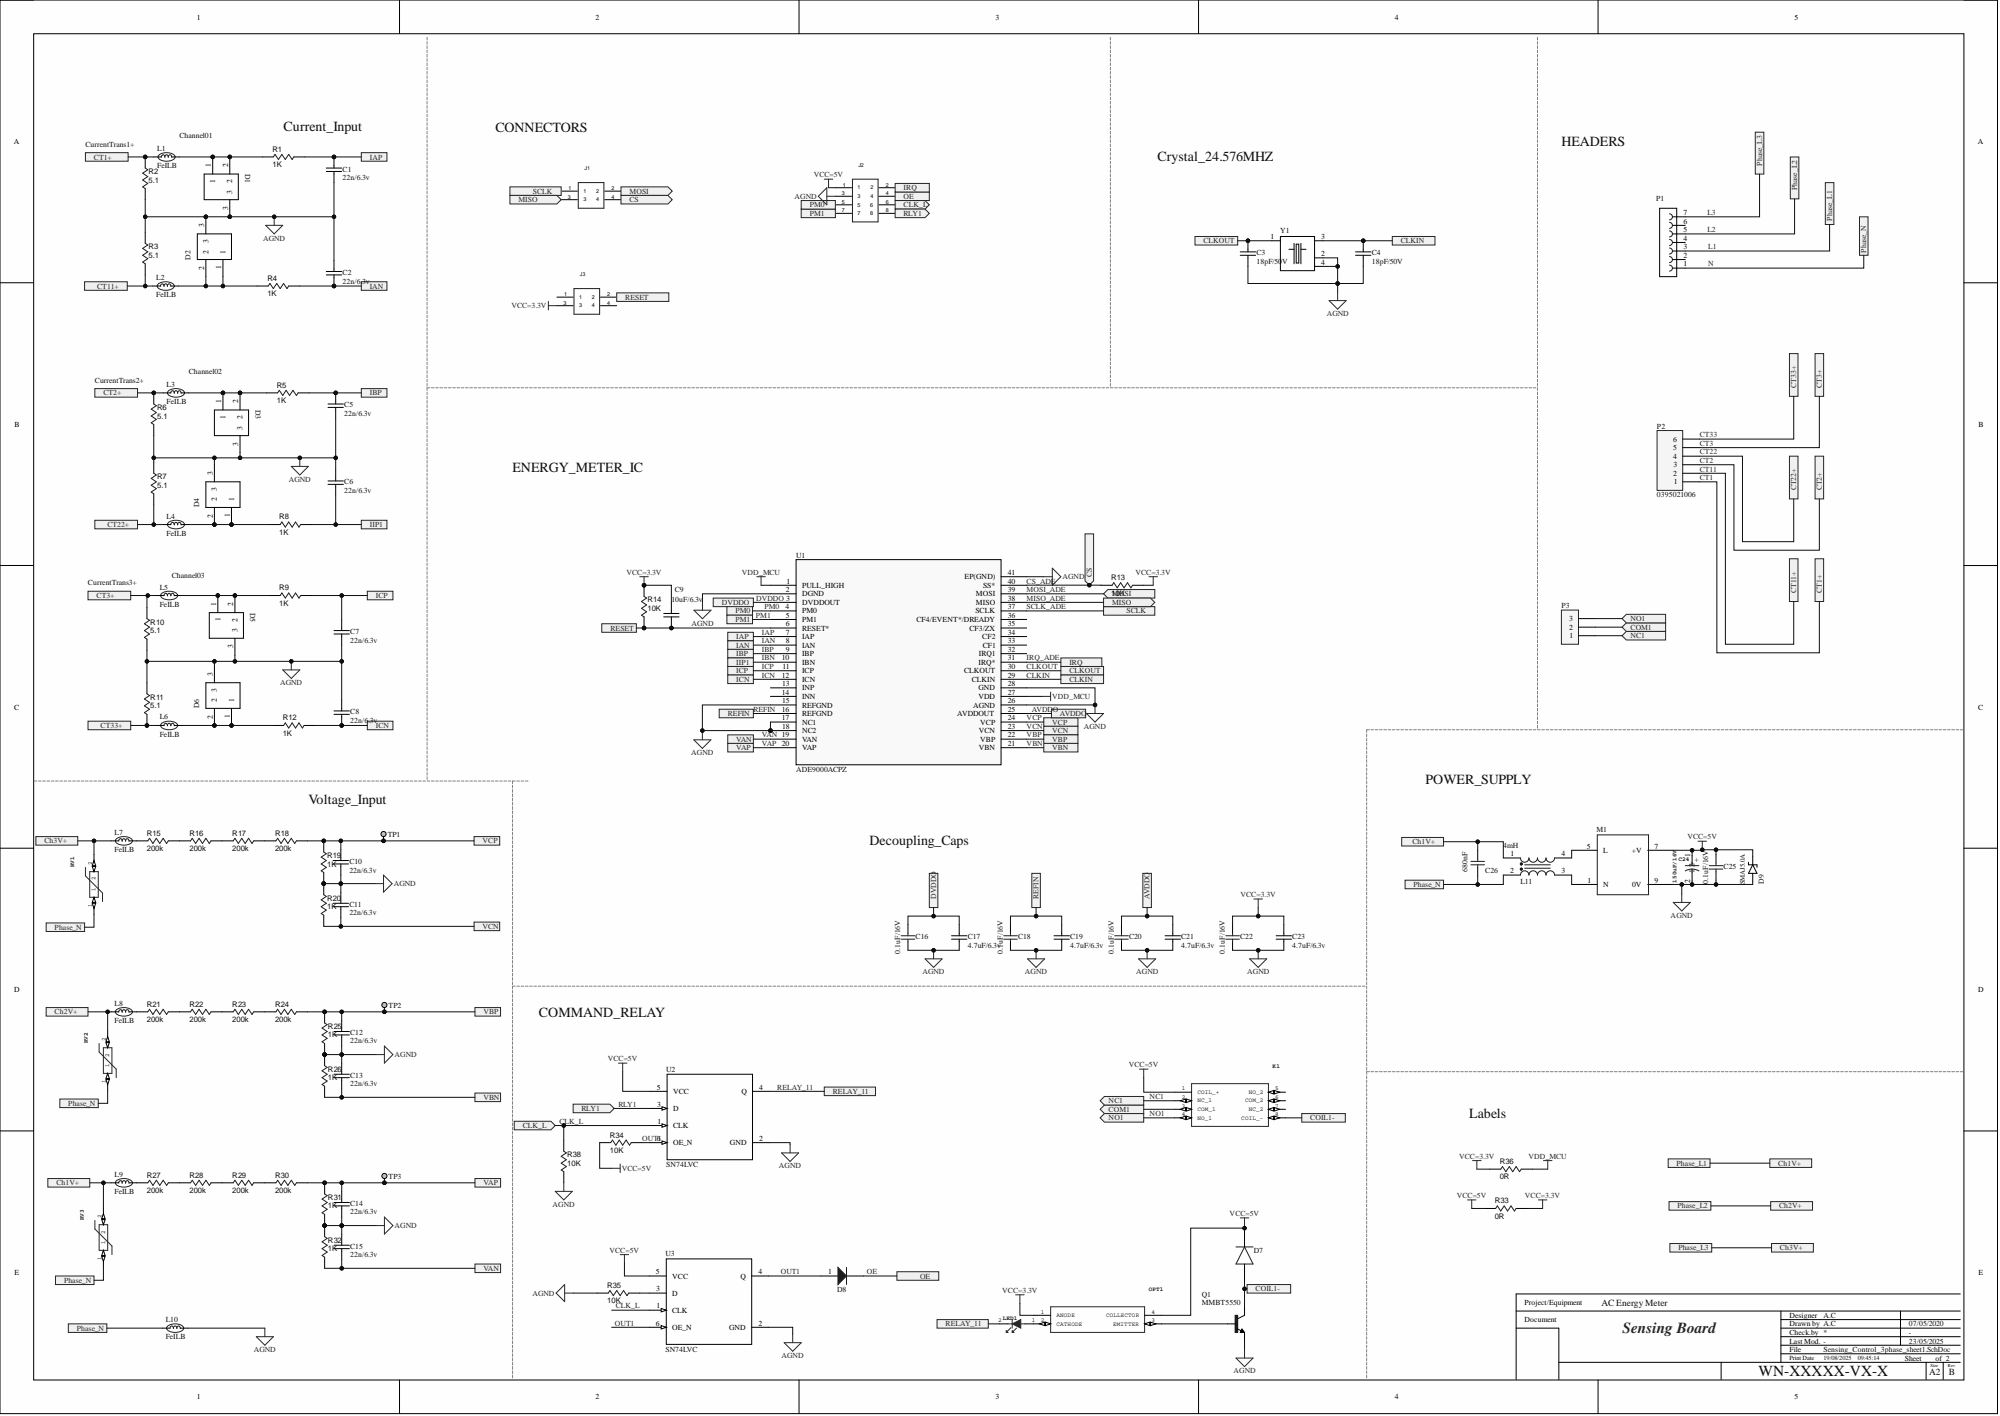
[picture p16: page 1]

CT2
CT11
CT1

ICP | ICP 11 | CLKOUT
ICN | ICN 12 | CLKIN

VAN 19 | VBP

VAP | | VBN

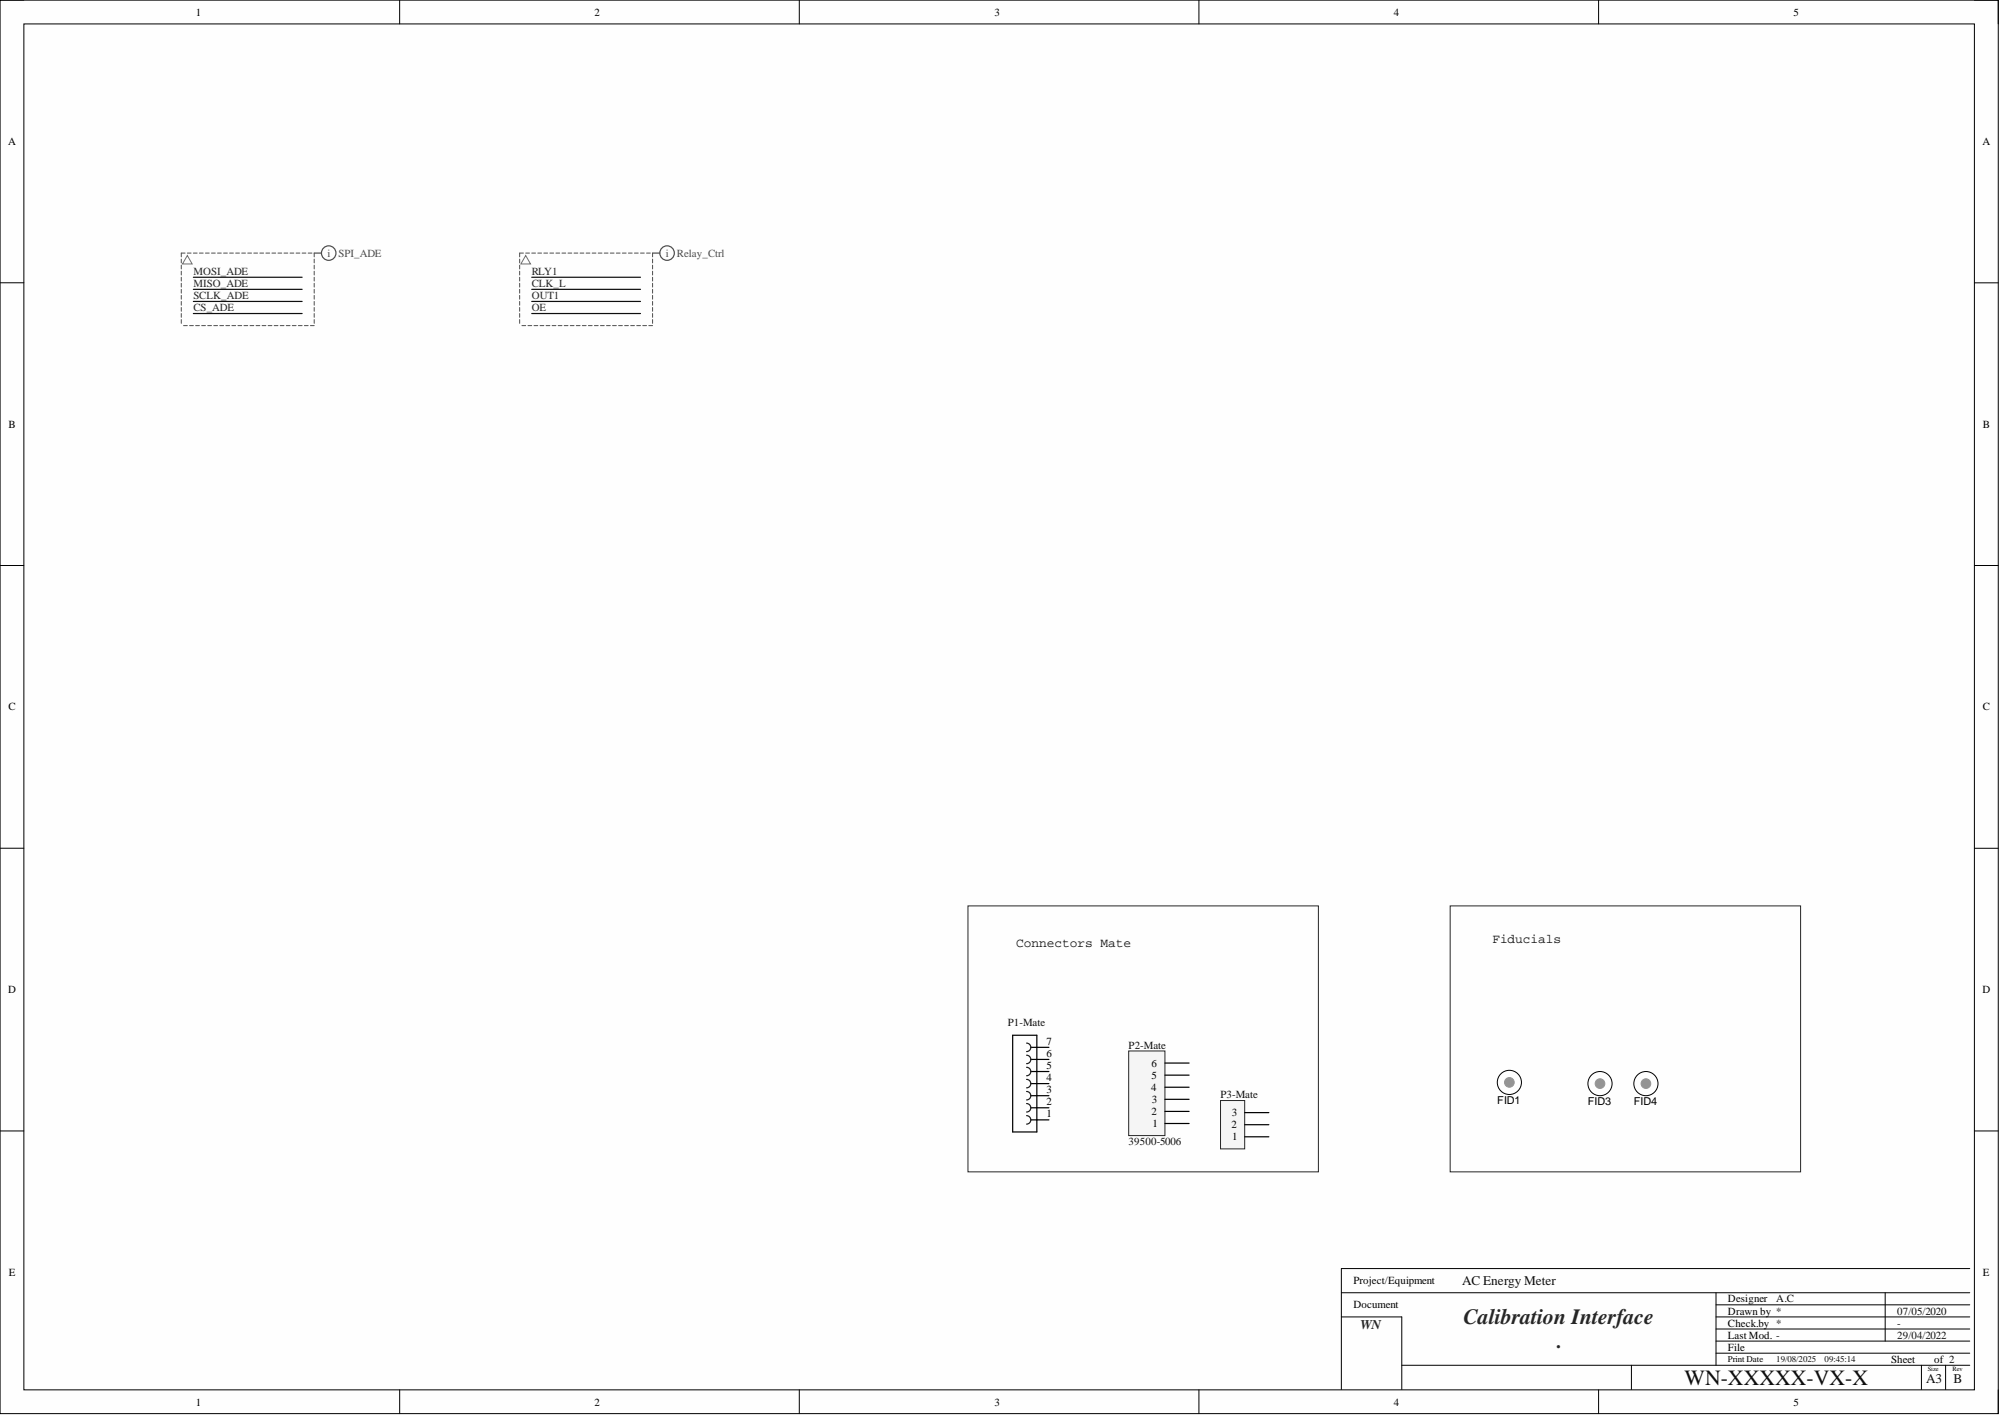
[picture p17: page 2]
