eSpark-Consulting-Group/issamsmaali-energymonitor/(list of files, drawings)

Other design files:
Design Files/Power_Board-V1.0/Connector_Sheet.SchDoc
Design Files/Power_Board-V1.0/Interface_Sheet.SchDoc
Design Files/Power_Board-V1.0/Metering_Sheet.SchDoc
Design Files/Power_Board-V1.0/Power_Board-V1.0.PcbDoc
Design Files/Power_Board-V1.0/Power_Board-V1.0.PrjPcb
Design Files/Power_Board-V1.0/Power_Supply_Sheet.SchDoc
