eSpark-Consulting-Group/issamsmaali-energymonitor/(commit log)

2025-09-15 #1 Backup commit
    [Interface_Sheet.SchDoc, Metering_Sheet.SchDoc, Power_Board-V1.0.PrjPcb, Power_Supply_Sheet.SchDoc]
2025-09-15 #1 Files updated, Client file updated
    [Interface_Sheet.SchDoc, Metering_Sheet.SchDoc, Power_Supply_Sheet.SchDoc]
2025-09-19 #1 Isolator updated, DC-DC converter added, Schematics updated
    [Connector_Sheet.SchDoc, Interface_Sheet.SchDoc, Metering_Sheet.SchDoc, Power_Board-V1.0.PrjPcb, Power_Supply_Sheet.SchDoc]
2025-09-23 #1 Relay added
    [Connector_Sheet.SchDoc, Interface_Sheet.SchDoc]
2025-10-01 Backup Commit
    [Connector_Sheet.SchDoc, Power_Board-V1.0.PrjPcb, Power_Supply_Sheet.SchDoc]
2025-11-07 #2 in progress
    [Interface_Sheet.SchDoc, Metering_Sheet.SchDoc, Power_Board-V1.0.PcbDoc, Power_Supply_Sheet.SchDoc]
2025-11-13 #2 PCB Design Completed
    [Interface_Sheet.SchDoc, Metering_Sheet.SchDoc, Power_Board-V1.0.PcbDoc, Power_Board-V1.0.PrjPcb, Power_Supply_Sheet.SchDoc]
2026-02-13 #1 #2 done
    [Centroide File.csv, Connector_Sheet.SchDoc, JLCPCB-BOM-Power-PCB-v1.0.xlsx, JLCPCB-BOM_Power_Board-V1.0.xlsx, Pick Place for Power_Board-V1.0.csv, Power_Board-V1.0.DWG, Power_Board-V1.0.DXF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]
2026-03-16 #2 HV Clearance updated.
    [Connector_Sheet.SchDoc, Power_Board-V1.0.PcbDoc, Power_Supply_Sheet.SchDoc]
